JEPAltam/FFF-3DPrinter-CoreXY-Duet-LoadCell/media/photos/assembly/electronic_integration.jpg

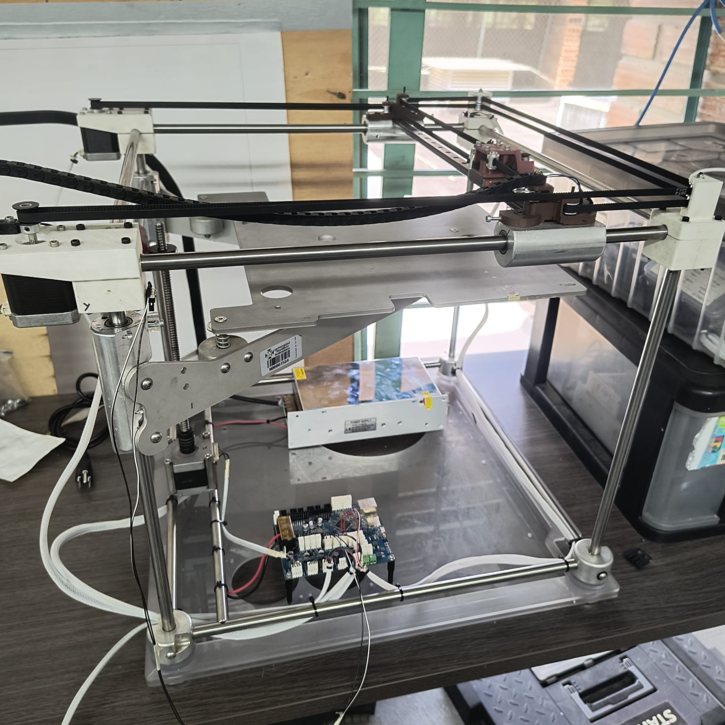
media/photos/assembly/electronic_integration.jpg
