JEPAltam/FFF-3DPrinter-CoreXY-Duet-LoadCell/media/photos/finished_machine/Complete_system_integration2.jpg

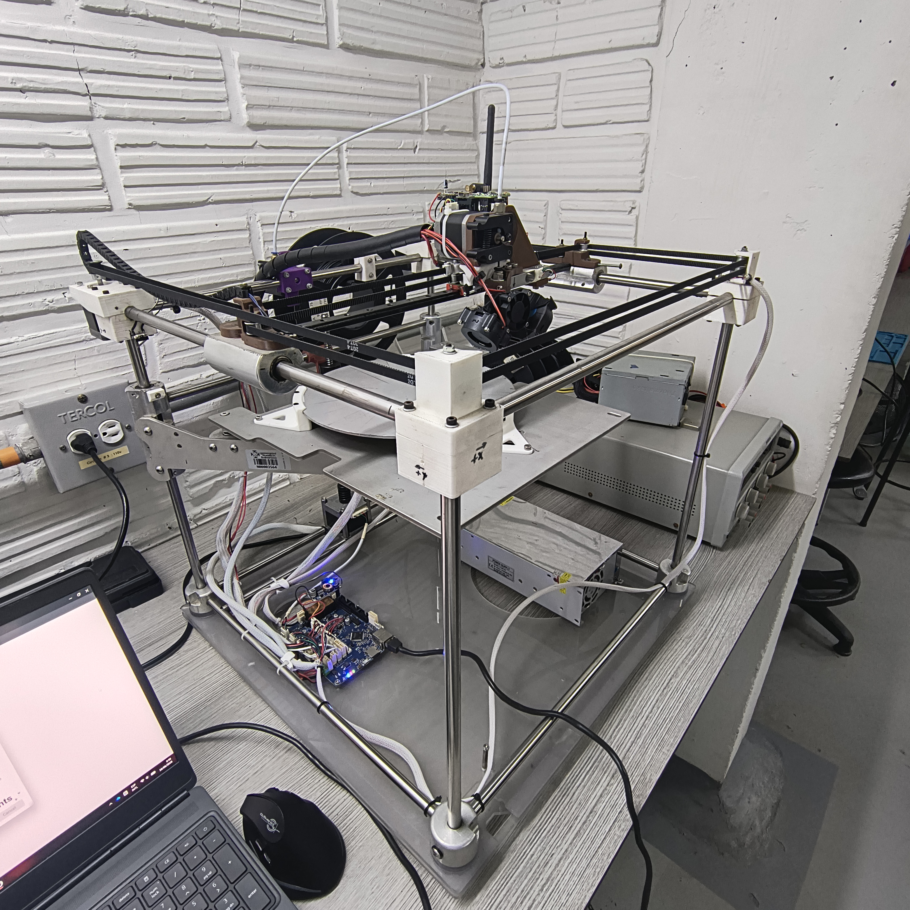
media/photos/finished_machine/Complete_system_integration2.jpg
