JEPAltam/FFF-3DPrinter-CoreXY-Duet-LoadCell/mechanical/bom/BOM.xlsx

Sheet: 1 - Mechanical BOM
Bill of Materials — Structural & Mechanical Components
Designator | Component | No. | Cost/unit (USD) | Total cost (USD) | Source of materials | Material type
STRUCTURAL FRAME
Structural_frame1/2; Z_Motor_mount1/2 and Z-smooth_rod | Stainless steel rod 12 mm × 500 mm. Reused legacy printer | 13 | 23.11 | 300.43 | https://es.aliexpress.com/item/1005009384686024.html | Metal
Corner_bracket_L/R/FL/FR | Printed corner bracket, PLA, 133 g | 4 | 1 | 4 | In-house FFF, UPB workshop | Polymer
Motor_mount_bracket_L/R | Printed motor mount, PLA, 121 g | 2 | 1.81 | 3.62 | In-house FFF, UPB workshop | Polymer
Pulley_mount_bracket_L/R | Printed pulley housing, PLA, 50 g | 2 | 0.75 | 1.5 | In-house FFF, UPB workshop | Polymer
Pulley_support_L/R | Printed pulley support, PLA, 29 g | 2 | 0.5 | 1 | In-house FFF, UPB workshop | Polymer
Nema 17 | NEMA 17 stepper motor, 0.6 N·m | 3 | 12.86 | 38.58 | https://es.aliexpress.com/item/1005010127780067.html | Metal
MGN12_rail | MGN12 linear guide rail, 400 mm | 1 | 18 | 18 | https://es.aliexpress.com/item/1005007149925240.html | Metal
Belt_lower/upper | GT2 timing belt, 6 mm wide, per metre | 2 | 4 | 8 | https://es.aliexpress.com/item/1005010670220355.html | Polymer
2GT_pulley20T | GT2 20-tooth drive pulley, 5 mm bore | 2 | 4.66 | 9.32 | https://es.aliexpress.com/item/1005012119340007.html | Metal
2GT_idler_16T | GT2 16-tooth idler pulley with bearing | 4 | 2 | 8 | https://es.aliexpress.com/item/1005004893007344.html | Metal
Microswitch | Endstop microswitch, SPDT, 1 A | 3 | 0.8 | 2.4 | https://es.aliexpress.com/item/1005009049556408.html | Semiconductor
Z-AXIS
Z-mount and Z-Endswitch_trigger | Printed Z-axis bracket, PLA, 11 g | 1 | 0.31 | 0.31 | In-house FFF, UPB workshop | Polymer
Z-axis_lead_screw | Reused legacy printer. Can be printed | 1 | 0.3 | 0.3 | In-house FFF, UPB workshop | Polymer
Trapezoidal_lead_screw_10mm | Trapezoidal lead screw T10, 2 mm pitch, 300 mm + nut | 1 | 10.23 | 10.23 | https://es.aliexpress.com/item/4000909583486.html | Metal
Flexible_coupling_6mm | D15 L22 6-6 mm. Connection to trapezoidal lead screw | 1 | 5 | 5 | https://es.aliexpress.com/item/1005005551683727.html | Metal
Linear_slide_bush_L/R and Z-sliding_bushing_L/R | Custom linear bushing, machined. Reused legacy printer | 4 | - | - | In-house UPB milling machine | Metal
Ball_sleeve_KH1228 | KH1228. Reused legacy printer | 4 | 15.6 | 62.4 | https://es.aliexpress.com/w/wholesale-KH1228.html | Metal
Nema 23 | NEMA 23 stepper motor, 1.3 N·m | 1 | 31 | 31 | https://es.aliexpress.com/item/1005004803177431.html | Metal
PRINT BED
Heat_bed | Heated bed, 200 mm dia., 24 V, 120 W. Reused Kossel delta. | 1 | 22 | 22 | https://es.aliexpress.com/item/1005010009605532.html | Metal
Bed_support | Machined. Reused legacy printer. | 1 | - | - | In-house, UPB workshop | Metal
Heat_bed_mount | Machined. Reused legacy printer. | 2 | - | - | In-house, UPB workshop | Metal
Heat_bed_support and Heat_bed_mount_support | Machined. Reused legacy printer. | 3 | - | - | In-house, UPB workshop | Metal
Centring_bracket and Clamp_centring_bracket | Printed centering bed, PLA, 73 g | 6 | 0.37 | 2.22 | In-house FFF, UPB workshop | Polymer
Leveling_feet and Leveling_feet_screw | Machined. Reused legacy printer. | 8 | - | - | In-house UPB workshop | Metal
Bed_feet | Reused legacy printer. | 1 | - | - | In-house UPB | Polymer
EXTRUDER AND HOTEND
E3DV5 | 3DV5 hotend assembly, 0.4 mm nozzle, 24 V | 1 | 20 | 20 | Reused from Anycubic Kossel Plus Delta | Metal
Extruder_body; Extruder_mount and X-Endswitch_trigger | Printed extruder body, PLA, 43.5 g | 3 | 1.3 | 3.9 | In-house FFF, UPB workshop | Polymer
4020TB | 40×20 mm radial blower fan, 12 V, 0.1 A | 2 | 3.14 | 6.28 | https://es.aliexpress.com/item/1005005517858332.html | Polymer
Fan_support | Printed part-cooling 4020 blower fan support, PLA, 7 g | 1 | 0.21 | 0.21 | In-house FFF, UPB workshop | Polymer
Duct_radial | Printed cooling fan heat skin, PLA, 7 g | 1 | 0.21 | 0.21 | In-house FFF, UPB workshop | Polymer
Duct_Blower1/2 | Printed duct layer fan, PLA, 5 g | 1 | 0.14 | 0.14 | In-house FFF, UPB workshop | Polymer
Fan4010 | 40×10 mm radial heat skin fan, 12 V, 0.1 A | 1 | 13 | 13 | https://es.aliexpress.com/item/1005006306536871.html | Polymer
Bowden_tube | PTFE tube, 2 mm ID / 4 mm OD, per metre | 1 | 13 | 13 | https://es.aliexpress.com/item/1005003579739761.html | Polymer
Extruder_MK8 | Kit idler pivot loaded system | 1 | 16.5 | 16.5 | https://es.aliexpress.com/item/1005003217904544.html | Metal
FORCE SENSING MODULE
Load_cell_75mm | Bending-beam load cell, 75 mm, 1 kg, ±0.05% FS | 1 | 14 | 14 | https://es.aliexpress.com/item/1005012383607240.html | Metal
HX711 | HX711 24-bit ADC amplifier board | 1 | 5 | 5 | https://es.aliexpress.com/item/1005012383607240.html | Semiconductor
Load_cell_mount; Load_cell_heatsink_support and Load_cell_heatsink_fastening | Printed load cell mounting bracket, PLA, 20 g | 3 | 0.7 | 2.1 | In-house FFF, UPB workshop | Polymer
Sensors_support_arm and Sensors_support | Printed sensor support, PLA, 18 g | 2 | 0.54 | 1.08 | In-house FFF, UPB workshop | Polymer
SUBTOTAL — Mechanical & Structural (USD) |  |  |  | 623.73

Sheet: 2 - Electronics BOM
Bill of Materials — Electronics & Cable Management
Designator | Component | No. | Cost/unit (USD) | Total cost (USD) | Source of materials | Material type
ELECTRONICS AND CONTROL
Duet3D_board | Duet Maestro 2, RepRapFirmware | 1 | 54 | 54 | https://es.aliexpress.com/item/1005005037824542.html | Semiconductor
Arduinonano | Arduino Nano V3.0 Mini CH340 | 2 | 15 | 30 | https://es.aliexpress.com/item/1005008982247575.html | Semiconductor
NRF24L01 | NRF24L01 + antenna | 2 | 4 | 8 | https://es.aliexpress.com/item/1005006975747743.html | Semiconductor
Power_supply | MeanWell LRS-350-24, 24 V / 14.6 A | 1 | 64 | 64 | https://es.aliexpress.com/item/1005009359704155.html | Metal
DC-DC_3A | DC-DC buck converter, 24 V to 5 V, 3 A | 1 | 4 | 4 | https://es.aliexpress.com/item/1005012415089723.html | Semiconductor
L15841 | DC-DC MP1584EN 3 A 3.3/5/9/12 V | 1 | 4 | 4 | https://es.aliexpress.com/item/1005012144215392.html | Semiconductor
CABLE MANAGEMENT
Energy_chain | Cable drag chain, 10 mm, 500 mm | 1 | 20 | 20 | https://es.aliexpress.com/w/wholesale-Cable-drag-chain-10mm.html | Polymer
Wire_clip | Printed wire routing clip, PLA, 19.5 g | 10 | 0.1 | 1 | In-house FFF, UPB workshop | Polymer
Wiring_harness | Shielded cables, connectors, ferrules | 1 | 20 | 20 | Local store | Wiring
Power_supply_anchors | Sheet metal part | 4 | - | - | In-house UPB workshop | Metal
Duet3D_board_separator | Printed spacer. Can be printed in PLA. | 5 | - | - | In-house FFF, UPB workshop | Polymer
SUBTOTAL — Electronics (USD) |  |  |  | 205.00

Sheet: 3 - Fasteners & Supplies
Bill of Materials — Fasteners & Consumable Supplies
Designator | Component | No. | Cost/unit (USD) | Total cost (USD) | Source of materials | Material type
FASTENERS
M3x5_screw | Socket head cap screw M3×5, DIN 913 | 10 | 0.04 | 0.4 | Local store | Metal
M3x6_screw | Socket head cap screw M3×6, DIN 912 | 2 | 0.05 | 0.1 | Local store | Metal
M3x8_set_screw | Set screw M3×8, DIN 912 | 4 | 0.05 | 0.2 | Local store | Metal
M3x12_screw | Socket head cap screw M3×12, DIN 912 | 25 | 0.05 | 1.25 | Local store | Metal
M3x16_screw | Socket head cap screw M3×16, DIN 912 | 16 | 0.05 | 0.8 | Local store | Metal
M3x20_screw | Socket head cap screw M3×20, DIN 912 | 20 | 0.06 | 1.2 | Local store | Metal
M3x25_screw | Socket head cap screw M3×25, DIN 912 | 18 | 0.06 | 1.08 | Local store | Metal
M3x30_screw | Socket head cap screw M3×30, DIN 912 | 10 | 0.07 | 0.7 | Local store | Metal
M3x40_screw | Socket head cap screw M3×40, DIN 912 | 8 | 0.08 | 0.64 | Local store | Metal
M3x50_screw | Socket head cap screw M3×50, DIN 912 | 6 | 0.09 | 0.54 | Local store | Metal
M4x10_screw | Socket head cap screw M4×10, DIN 912 | 8 | 0.06 | 0.48 | Local store | Metal
M4x40_countersunk_screw | Socket countersunk screw M4×40 | 3 | 0.06 | 0.18 | Local store | Metal
M5x8_screw | Socket head cap screw M5×8, DIN 912 | 8 | 0.07 | 0.56 | Local store | Metal
M5x12_screw | Round head screw M5×12 | 20 | 0.07 | 1.4 | Local store | Metal
M5x60_screw | Socket head cap screw M5×60, DIN 912 | 4 | 0.09 | 0.36 | Local store | Metal
M1.6x10_screw | Microswitch fixing screw M1.6×10 | 6 | 0.05 | 0.3 | Local store | Metal
M3_nut | Hex nut M3, DIN 934 | 30 | 0.03 | 0.9 | Local store | Metal
M4_nut | Hex nut M4, DIN 934 | 2 | 0.03 | 0.09 | Local store | Metal
M4_Locknut | Hex lock nut M4 | 3 | 0.03 | 0.09 | Local store | Metal
M3_washer | Flat washer M3, DIN 125 | 30 | 0.02 | 0.6 | Local store | Metal
CONSUMABLE SUPPLIES
PLA | Filament PLA, 1 Kg, 1.75 mm | 1 | 62.35 | 62.35 | https://es.aliexpress.com/item/1005005828203221.html | Polymer
Cable sleeve | Cable sleeve 25 mm × 3 m | 1 | 14.5 | 14.5 | https://es.aliexpress.com/item/1005011969040670.html | Polymer
Heat-shrinkable sleeve | Heat-shrinkable sleeve, 127 pieces set | 1 | 14 | 14 | https://es.aliexpress.com/item/1005008146302901.html | Polymer
Plastic clamps | Plastic clamps 2.5 mm × 150 mm, 200 pieces | 1 | 15 | 15 | https://es.aliexpress.com/item/1005008455611389.html | Polymer
Hot-melt adhesive | Hot-melt adhesive 11 mm × 150 mm, 10 pieces | 1 | 18 | 18 | https://es.aliexpress.com/item/4000748720733.html | Polymer
SUBTOTAL — Fasteners & Supplies (USD) |  |  |  | 135.72

Sheet: 4 - Grand Total Summary
Bill of Materials — Grand Total Summary
Category | Subtotal (USD) | Notes
Structural & Mechanical Components | $623.73 | Tables 5 (paper)
Electronics & Cable Management | $205.00 | Table 6 (paper)
Fasteners & Consumable Supplies | $135.72 | Table 7 (paper)
GRAND TOTAL | $964.45 | Total estimated cost (USD)
Note: Cells marked '-' are reused or machined in-house with no direct material cost. Corrected totals applied: Extruder_body (3×$1.30=$3.90), Load_cell_mount (3×$0.70=$2.10), Sensors_support_arm (2×$0.54=$1.08).
