JEPAltam/FFF-3DPrinter-CoreXY-Duet-LoadCell/(list of files, cad)

Other CAD files:
mechanical/CAD/1.1_Parts/1.1.3_Electronic/Power_supply_anchors.psm
mechanical/CAD/1.1_Parts/1.1.7_Extruder/Spool_holder.psm
