JEPAltam/FFF-3DPrinter-CoreXY-Duet-LoadCell/mechanical/drawings/Assembly_Bill_materials.pdf

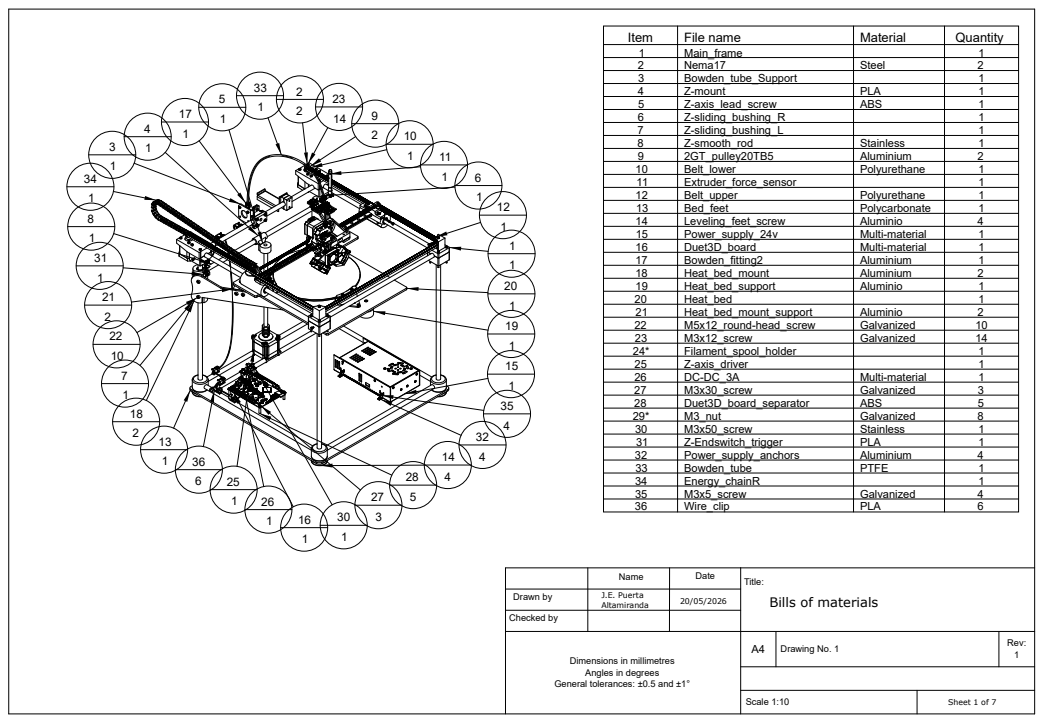
[picture p7: page 1]
Item; File name; Material; Quantity 1; Main_frame; Nema17; Steel; Bowden_tube_Support; Z-mount; PLA; Z-axis_lead_screw; ABS; Z-sliding_bushing_R; Z-sliding_bushing_L; Z-smooth_rod; Stainless; 2GT_pulley20TB5; Aluminium; Belt_lower; Polyurethane; Extruder_force_sensor; Belt_upper; Bed_feet; Polycarbonate; Leveling_feet_screw; Aluminio; Power_supply_24v; Multi-material; Duet3D_board; Bowden_fitting2; Heat_bed_mount; Heat_bed_support; Heat_bed; Heat_bed_mount_support; M5x12_round-head_screw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

Bills of materials

Dimensions in millimetres
Angles in degrees
General tolerances: ±0.5 and ±1°

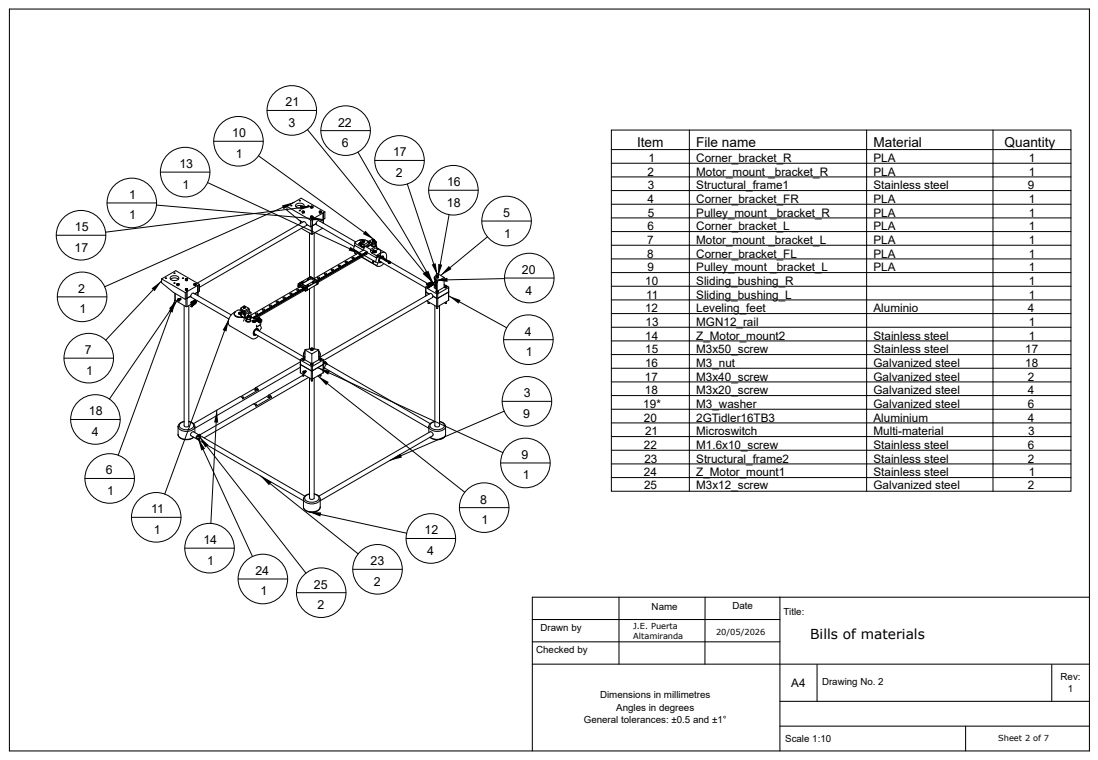
[picture p8: page 2]
Item; File name; Material; Quantity 1; Corner_bracket_R; PLA; Motor_mount _bracket_R; Structural_frame1; Stainless steel; Corner_bracket_FR; Pulley_mount _bracket_R; Corner_bracket_L; Motor_mount _bracket_L; Corner_bracket_FL; Pulley_mount _bracket_L; Sliding_bushing_R; Sliding_bushing_L; Leveling_feet; Aluminio; MGN12_rail; Z_Motor_mount2; M3x50_screw; M3_nut; Galvanized steel; M3x40_screw; M3x20_screw; M3_washer; 2GTidler16TB3; Aluminium; Microswitch; Multi-material; M1.6x10_screw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

Name | Date | Title: Bills of materials

Drawn by | J.E. Puerta Altamiranda | 20/05/2026

Checked by

Dimensions in millimetres Angles in degrees General tolerances: ±0.5 and ±1° | A4 | Drawing No. 2 | Rev: 1

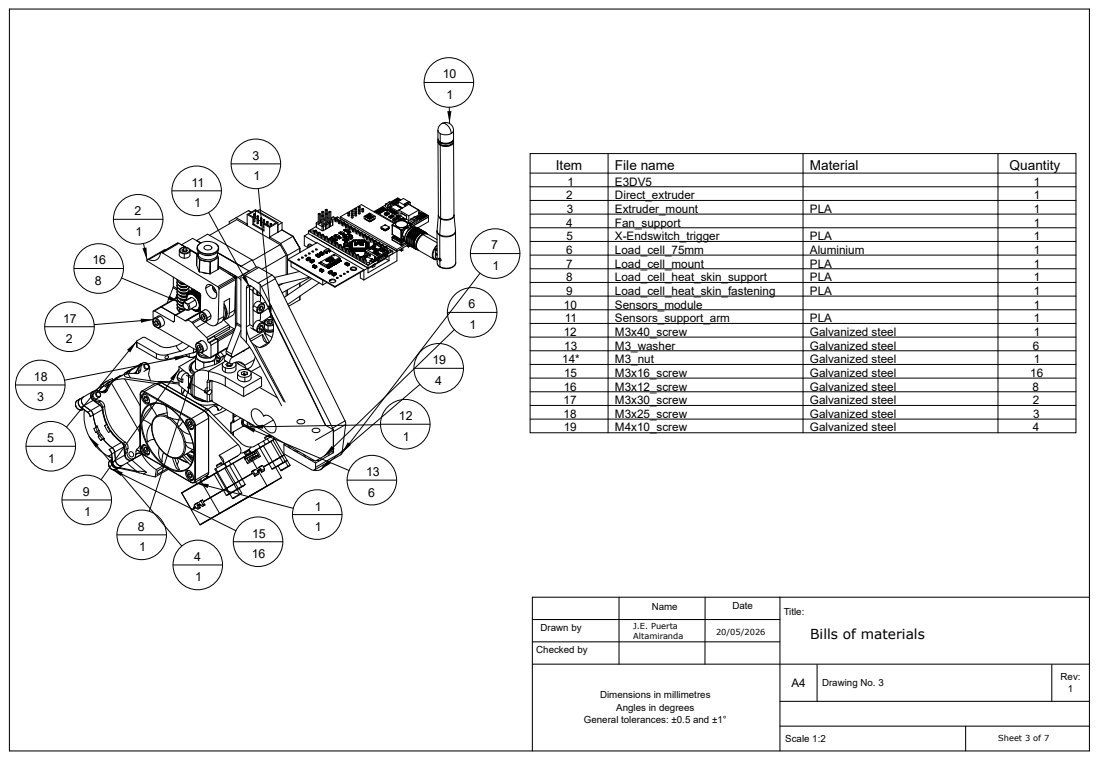
[picture p9: page 3]
Item; File name; Material; Quantity 1; Direct_extruder; Extruder_mount; PLA; Fan_support; X-Endswitch_trigger; Load_cell_75mm; Aluminium; Load_cell_mount; Load_cell_heat_skin_support; Load_cell_heat_skin_fastening; Sensors_module; Sensors_support_arm; M3x40_screw; Galvanized steel; M3_washer; M3_nut; M3x16_screw; M3x12_screw; M3x30_screw; M3x25_screw; M4x10_screw; Drawn by; Checked by; Name; Date; Title:; Drawing No. 3; Rev: 1; J.E. Puerta; Altamiranda

Bills of materials

Dimensions in millimetres
Angles in degrees
General tolerances: ±0.5 and ±1°

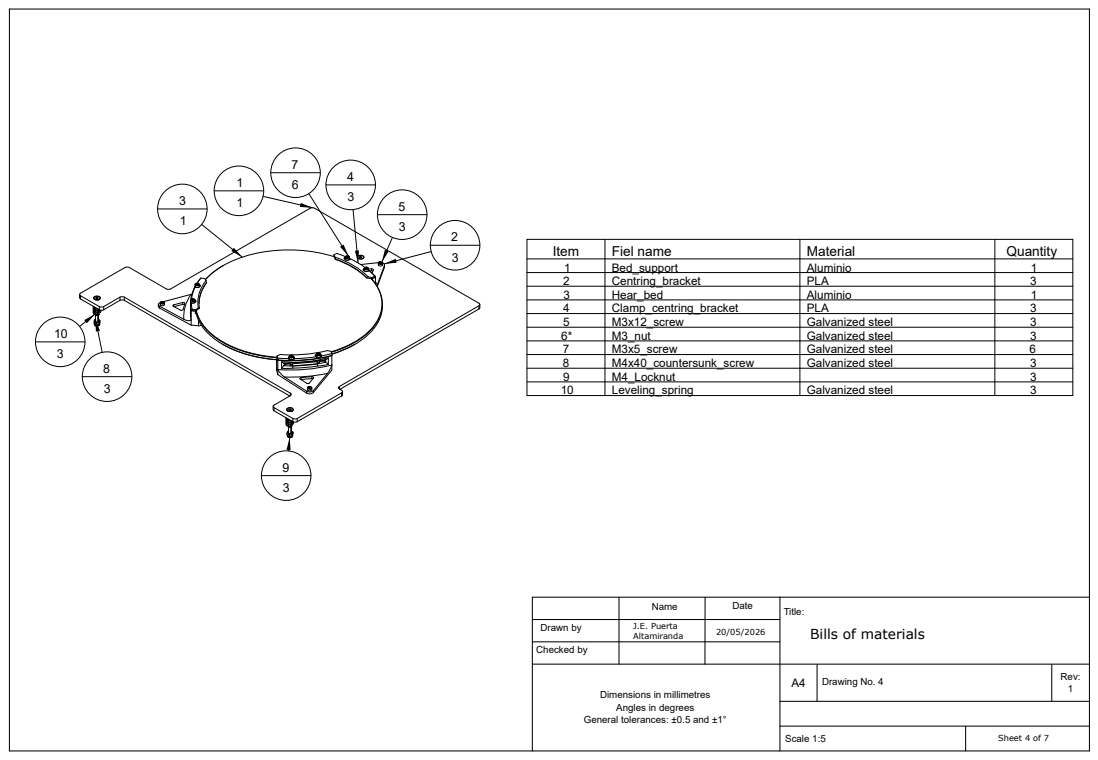
[picture p10: page 4]
Item; Fiel name; Material; Quantity 1; Bed_support; Aluminio; Centring_bracket; PLA; Hear_bed; Clamp_centring_bracket; M3x12_screw; Galvanized steel; M3_nut; M3x5_screw; M4x40_countersunk_screw; M4_Locknut; Leveling_spring

Name | Date | Title: Bills of materials

Drawn by | J.E. Puerta Altamiranda | 20/05/2026

Checked by

Dimensions in millimetres Angles in degrees General tolerances: ±0.5 and ±1° | A4 | Drawing No. 4 | Rev: 1

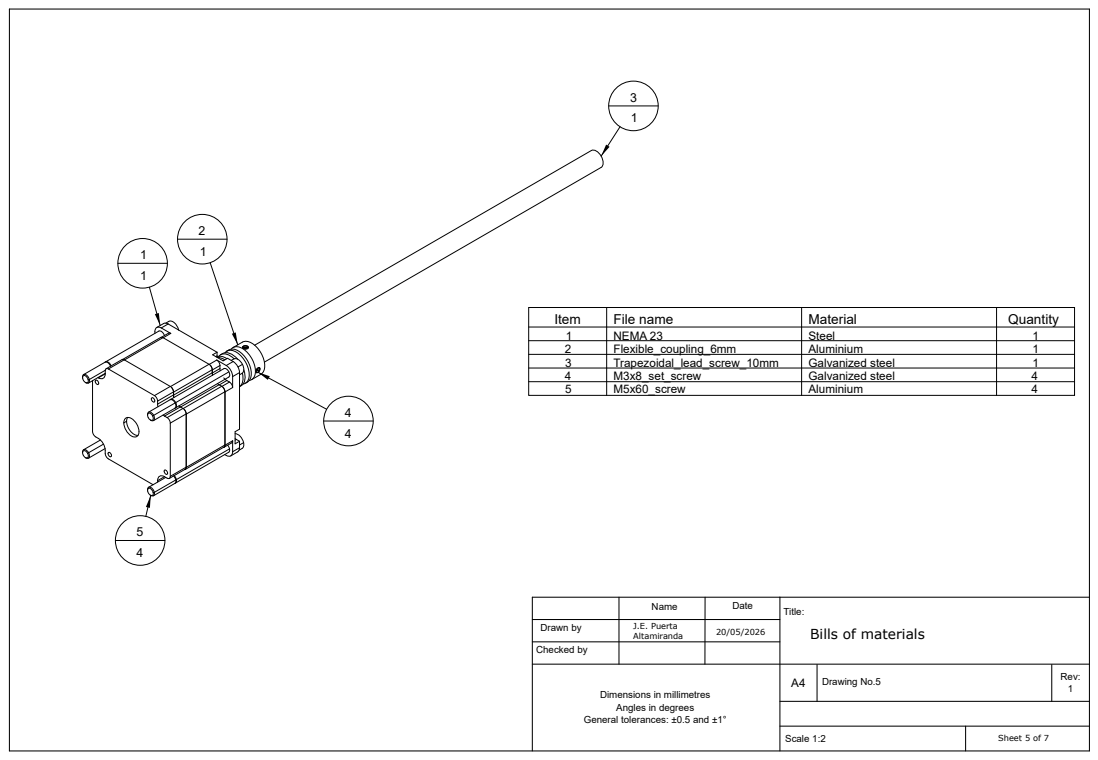
[picture p11: page 5]
Item; File name; Material; Quantity; NEMA 23; Steel; Flexible_coupling_6mm; Aluminium; Trapezoidal_lead_screw_10mm; Galvanized steel; M3x8_set_screw; M5x60_screw

Name | Date | Title: Bills of materials

Drawn by | J.E. Puerta Altamiranda | 20/05/2026

Checked by

Dimensions in millimetres Angles in degrees General tolerances: ±0.5 and ±1° | A4 | Drawing No.5 | Rev: 1

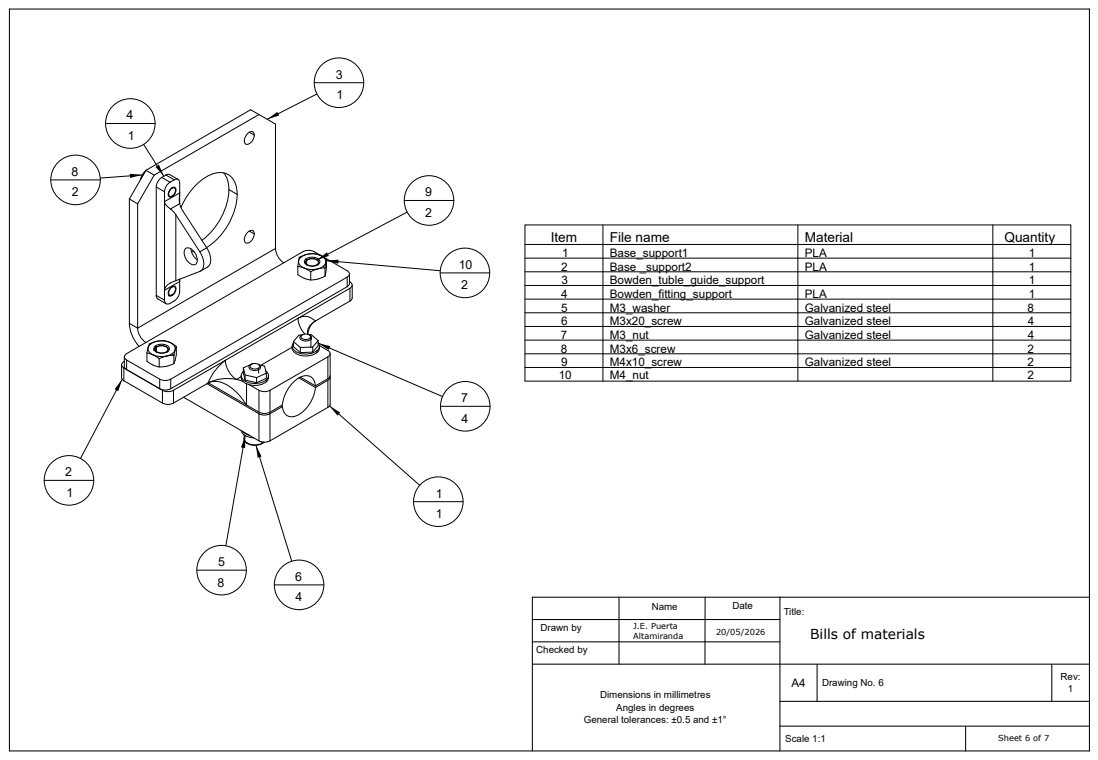
[picture p12: page 6]
Item; File name; Material; Quantity 1; Base_support1; PLA; Base _support2; Bowden_tuble_guide_support; Bowden_fitting_support; M3_washer; Galvanized steel; M3x20_screw; M3_nut; M3x6_screw; M4x10_screw; M4_nut

Name | Date | Title: Bills of materials

Drawn by | J.E. Puerta Altamiranda | 20/05/2026

Checked by

Dimensions in millimetres Angles in degrees General tolerances: ±0.5 and ±1° | A4 | Drawing No. 6 | Rev: 1

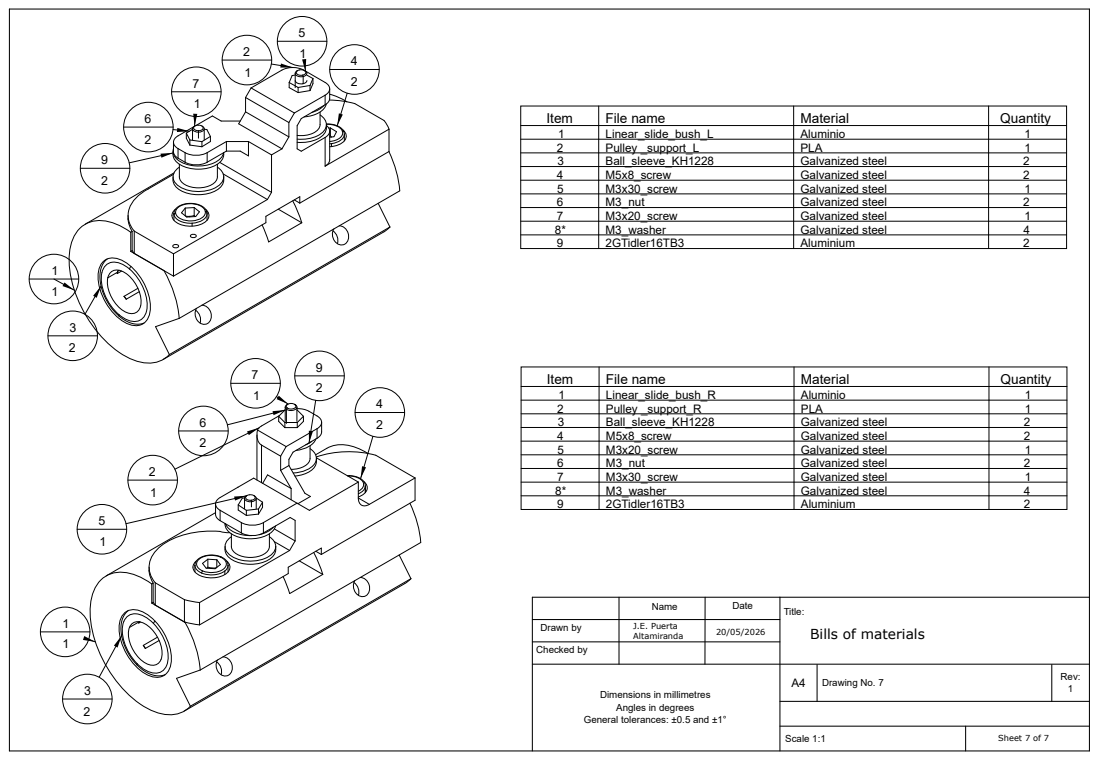
[picture p13: page 7]
Item; File name; Material; Quantity 1; Linear_slide_bush_L; Aluminio; Pulley _support_L; PLA; Ball_sleeve_KH1228; Galvanized steel; M5x8_screw; M3x30_screw; M3_nut; M3x20_screw; M3_washer; 2GTidler16TB3; Aluminium; Linear_slide_bush_R; Pulley _support_R

Name | Date | Title: Bills of materials

Drawn by | J.E. Puerta Altamiranda | 20/05/2026

Checked by

Dimensions in millimetres Angles in degrees General tolerances: ±0.5 and ±1° | A4 | Drawing No. 7 | Rev: 1
