JEPAltam/FFF-3DPrinter-CoreXY-Duet-LoadCell/mechanical/drawings/Assembly_drawing.pdf

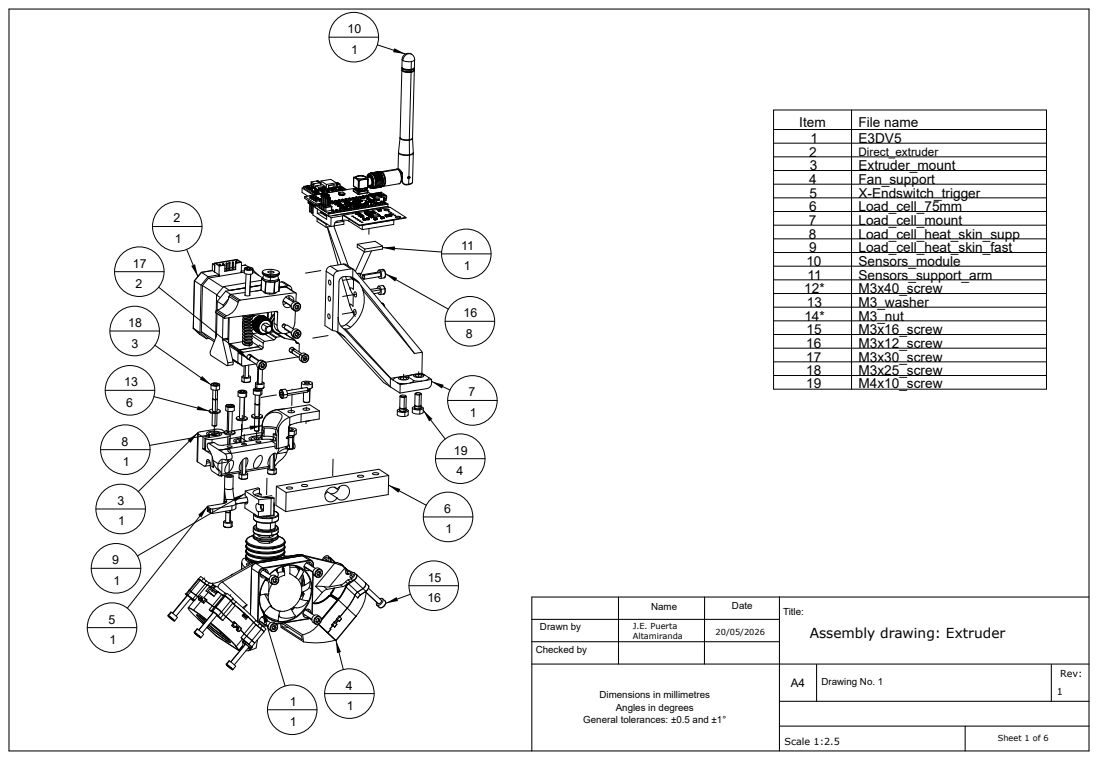
[picture p14: page 1]
Item; File name 1; Direct_extruder 3; Extruder_mount 4; Fan_support 5; X-Endswitch_trigger 6; Load_cell_75mm 7; Load_cell_mount 8; Load_cell_heat_skin_supp 9; Load_cell_heat_skin_fast; Sensors_module; Sensors_support_arm; M3x40_screw; M3_washer; M3_nut; M3x16_screw; M3x12_screw; M3x30_screw; M3x25_screw; M4x10_screw; Drawn by; Checked by; Name; Date; Title:; Drawing No. 1; J.E. Puerta; Altamiranda; Sheet 1 of 6; Rev: 1; Scale 1:2.5

Assembly drawing: Extruder

Dimensions in millimetres
Angles in degrees
General tolerances: ±0.5 and ±1°

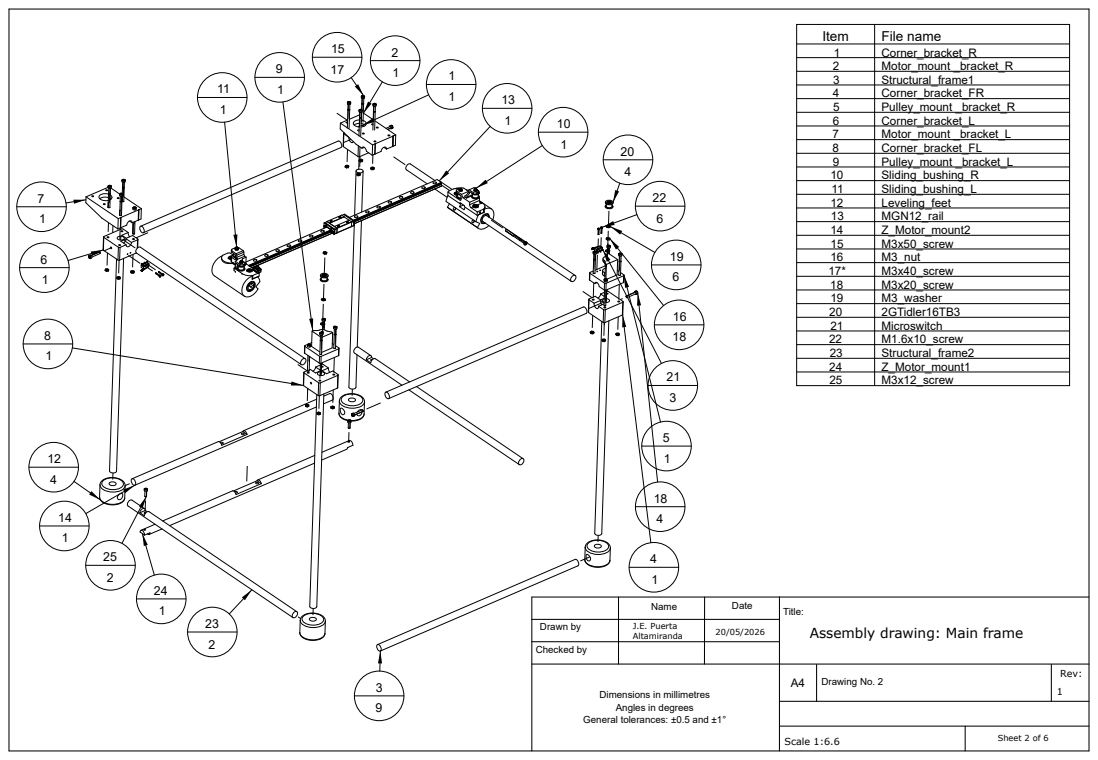
[picture p15: page 2]
Item; File name 1; Corner_bracket_R 2; Motor_mount _bracket_R 3; Structural_frame1 4; Corner_bracket_FR 5; Pulley_mount _bracket_R 6; Corner_bracket_L 7; Motor_mount _bracket_L 8; Corner_bracket_FL 9; Pulley_mount _bracket_L; Sliding_bushing_R; Sliding_bushing_L; Leveling_feet; MGN12_rail; Z_Motor_mount2; M3x50_screw; M3_nut; M3x40_screw; M3x20_screw; M3_washer; 2GTidler16TB3; Microswitch; M1.6x10_screw; Structural_frame2; Z_Motor_mount1; M3x12_screw; Scale 1:6.6

Name | Date | Title: Assembly drawing: Main frame

Drawn by | J.E. Puerta Altamiranda | 20/05/2026

Checked by

Dimensions in millimetres Angles in degrees General tolerances: ±0.5 and ±1° | A4 | Drawing No. 2 | Rev: 1

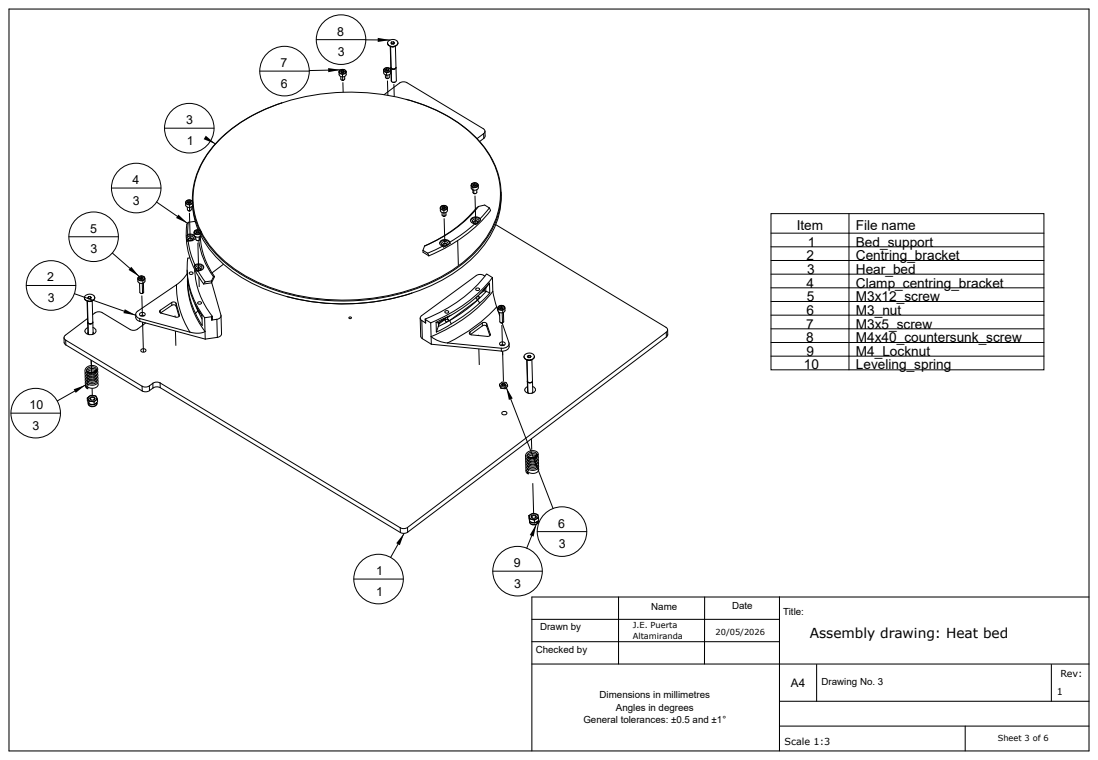
[picture p16: page 3]
Item; File name; Bed_support; Centring_bracket; Hear_bed; Clamp_centring_bracket; M3x12_screw; M3_nut; M3x5_screw; M4x40_countersunk_screw; M4_Locknut; Leveling_spring; Scale 1:3

Name | Date | Title: Assembly drawing: Heat bed

Drawn by | J.E. Puerta Altamiranda | 20/05/2026

Checked by

Dimensions in millimetres Angles in degrees General tolerances: ±0.5 and ±1° | A4 | Drawing No. 3 | Rev: 1

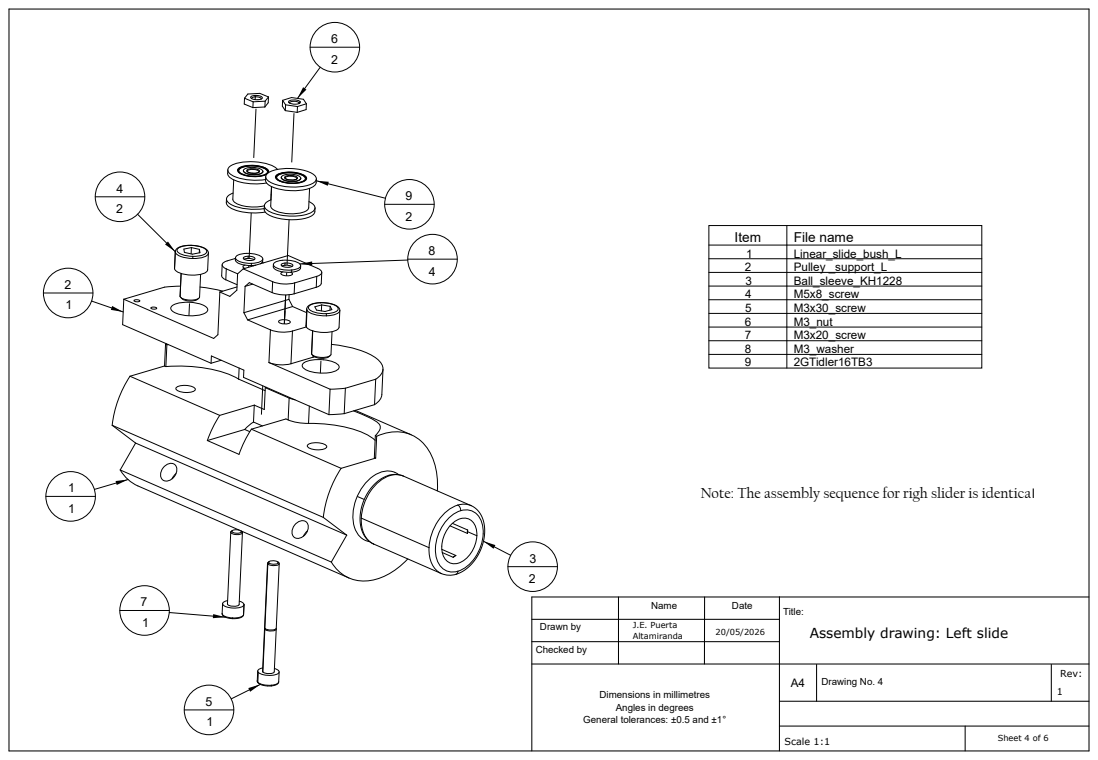
[picture p17: page 4]
Item; File name; Linear_slide_bush_L; Pulley _support_L; Ball_sleeve_KH1228; M5x8_screw; M3x30_screw; M3_nut; M3x20_screw; M3_washer; 2GTidler16TB3

Note: The assembly sequence for righ slider is identical

Name | Date | Title: Assembly drawing: Left slide

Drawn by | J.E. Puerta Altamiranda | 20/05/2026

Checked by

Dimensions in millimetres Angles in degrees General tolerances: ±0.5 and ±1° | A4 | Drawing No. 4 | Rev: 1

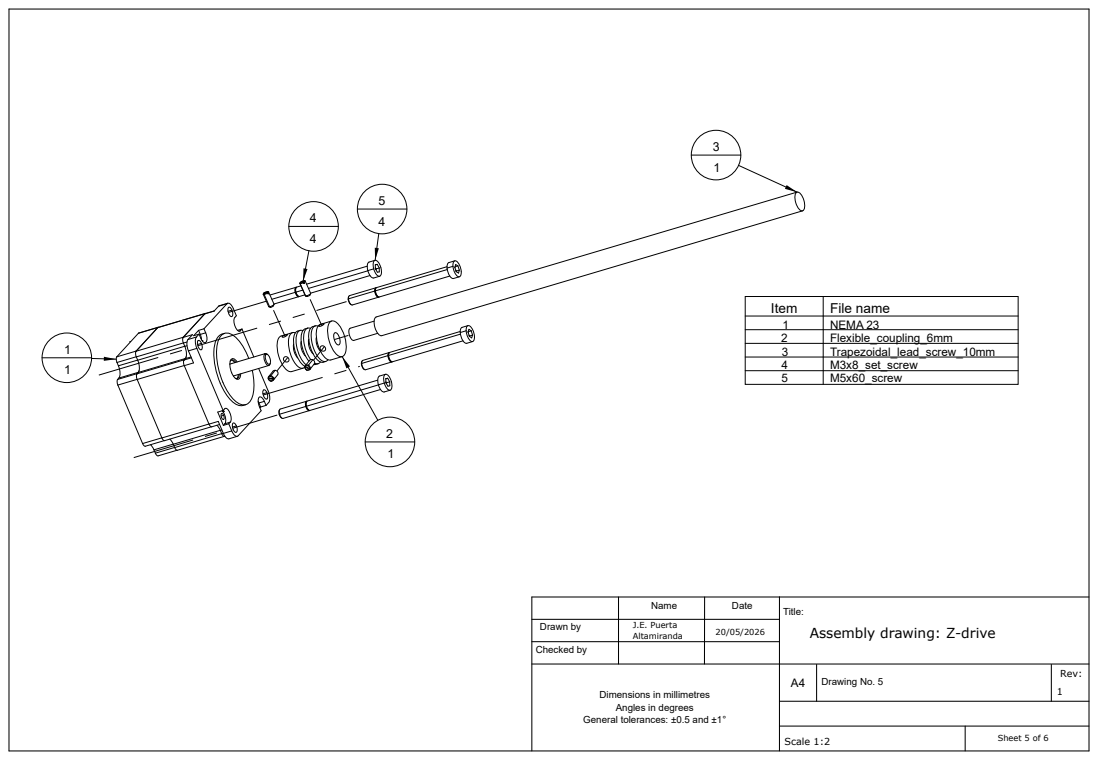
[picture p18: page 5]
Item; File name; NEMA 23; Flexible_coupling_6mm; Trapezoidal_lead_screw_10mm; M3x8_set_screw; M5x60_screw

Name | Date | Title: Assembly drawing: Z-drive

Drawn by | J.E. Puerta Altamiranda | 20/05/2026

Checked by

Dimensions in millimetres Angles in degrees General tolerances: ±0.5 and ±1° | A4 | Drawing No. 5 | Rev: 1

C

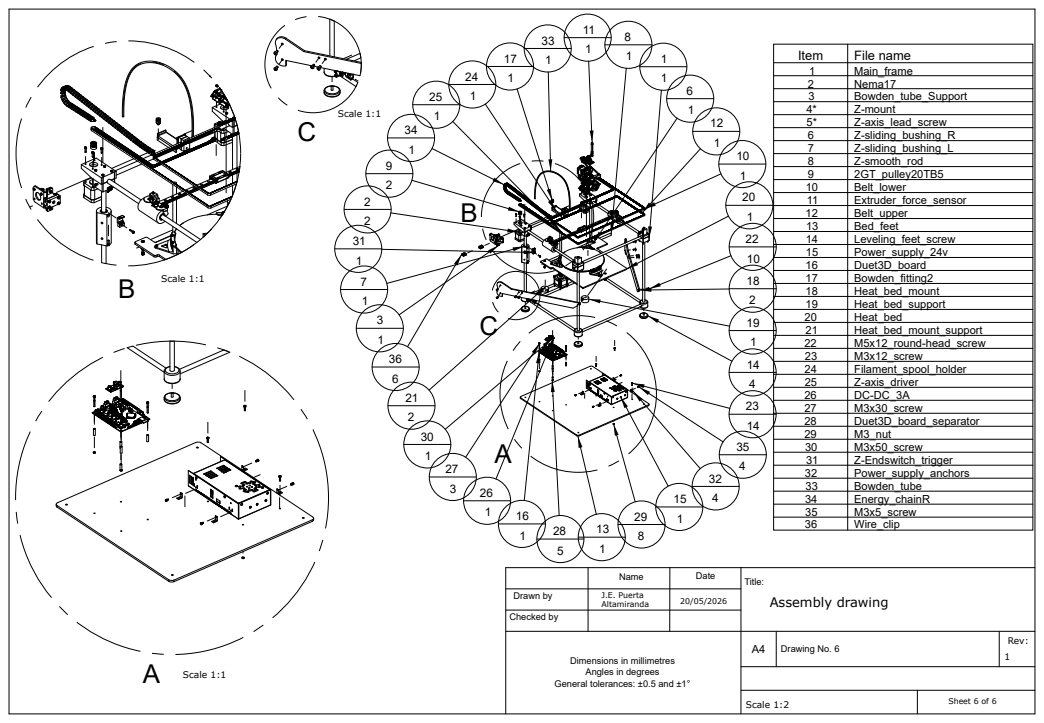
[picture p19: page 6]
Item; File name; Main_frame; Nema17; Bowden_tube_Support; Z-mount; Z-axis_lead_screw; Z-sliding_bushing_R; Z-sliding_bushing_L; Z-smooth_rod; 2GT_pulley20TB5; Belt_lower; Extruder_force_sensor; Belt_upper; Bed_feet; Leveling_feet_screw; Power_supply_24v; Duet3D_board; Bowden_fitting2; Heat_bed_mount; Heat_bed_support; Heat_bed; Heat_bed_mount_support; M5x12_round-head_screw; M3x12_screw; Filament_spool_holder; Z-axis_driver; M3x30_screw; Duet3D_board_separator; M3_nut; M3x50_screw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

Dimensions in millimetres
Angles in degrees
General tolerances: ±0.5 and ±1°
