JEPAltam/FFF-3DPrinter-CoreXY-Duet-LoadCell/mechanical/CAD/1.2_Assemblys/1.2.1_ASM/Reactivation_Upgrading_FFF_3D_Printer_CoreXY_2.pdf

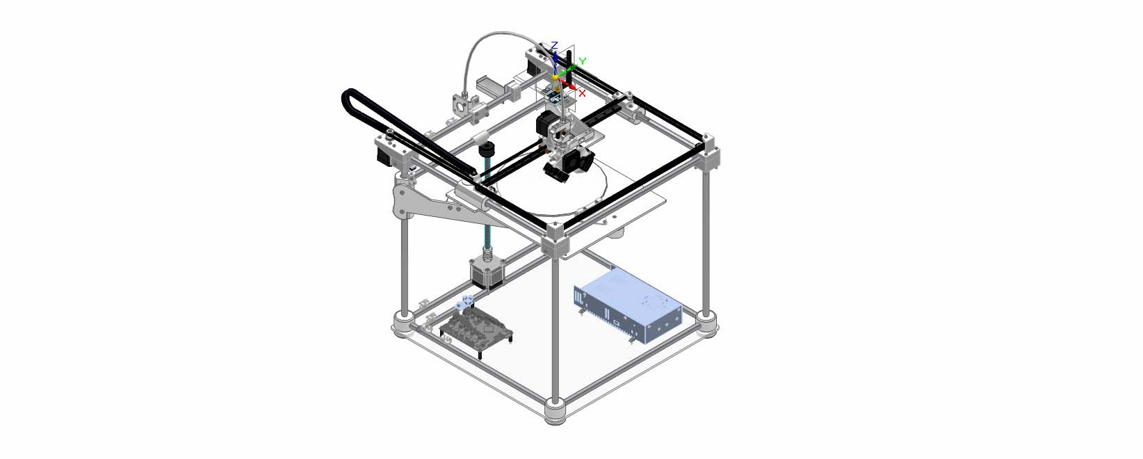
[picture p20: figure]
