JEPAltam/FFF-3DPrinter-CoreXY-Duet-LoadCell/media/photos/assembly/corner_bracket_1.jpg

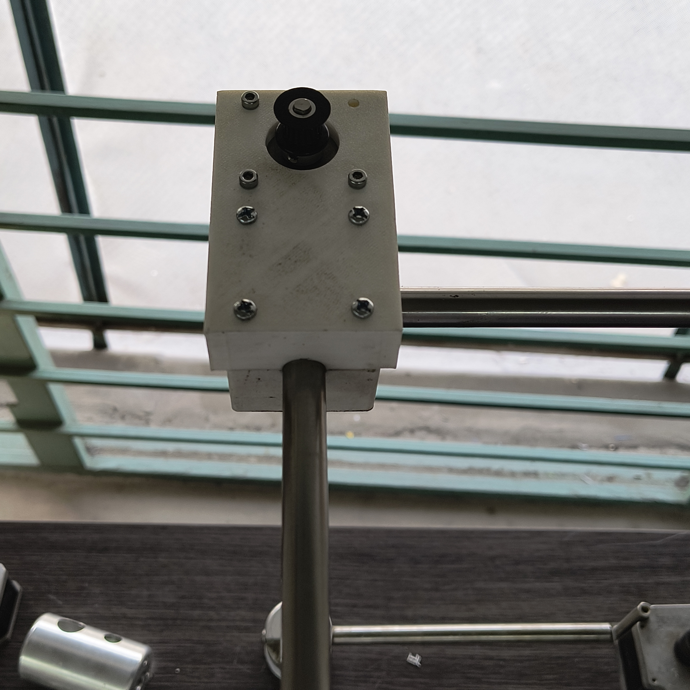
media/photos/assembly/corner_bracket_1.jpg
