JEPAltam/FFF-3DPrinter-CoreXY-Duet-LoadCell/media/photos/assembly/corner_bracket_2.jpg

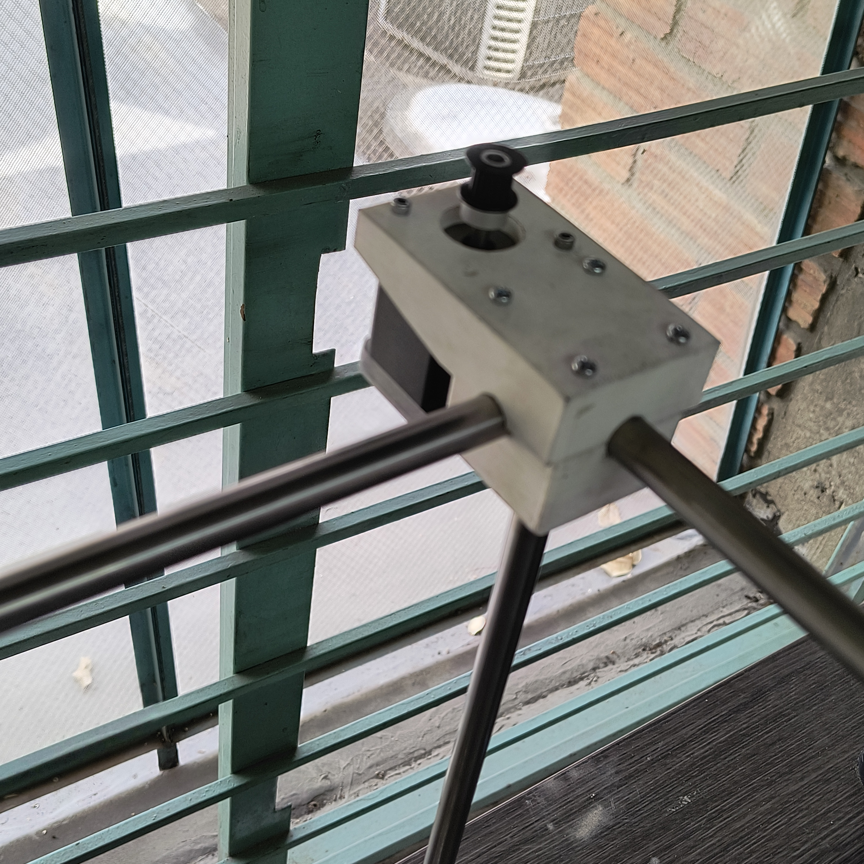
media/photos/assembly/corner_bracket_2.jpg
