JEPAltam/FFF-3DPrinter-CoreXY-Duet-LoadCell/media/photos/assembly/electric_conection.jpg

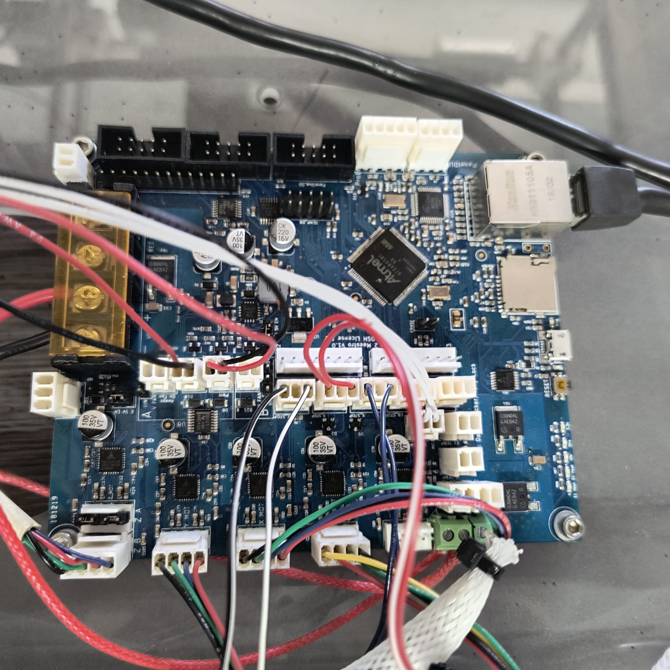
media/photos/assembly/electric_conection.jpg
