JEPAltam/FFF-3DPrinter-CoreXY-Duet-LoadCell/media/photos/assembly/linear_slide_bush.jpg

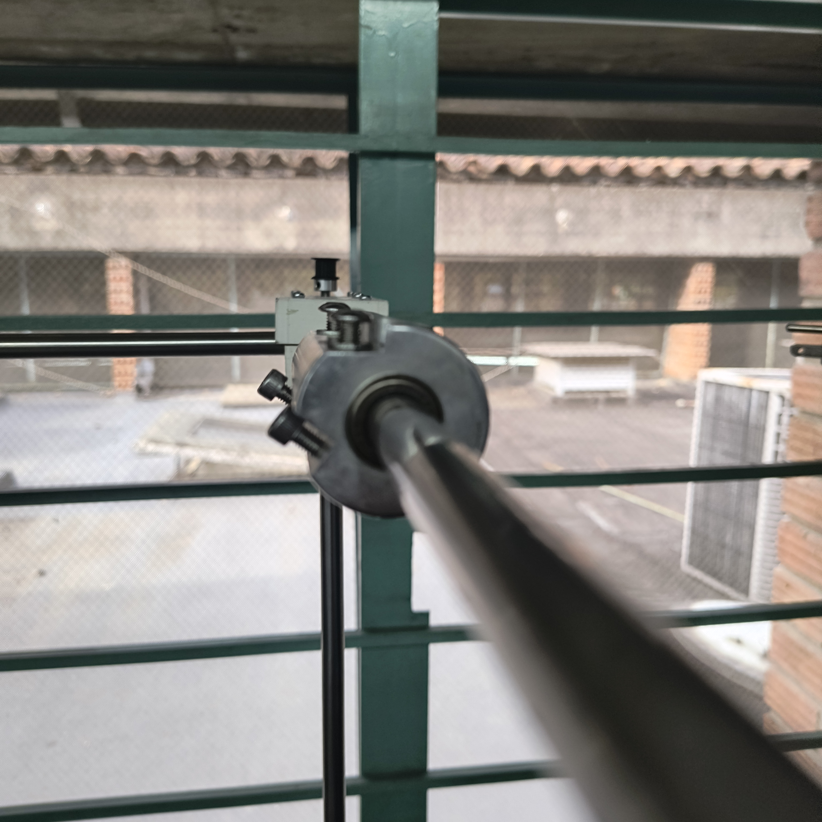
media/photos/assembly/linear_slide_bush.jpg
