JEPAltam/FFF-3DPrinter-CoreXY-Duet-LoadCell/media/photos/assembly/Machining.jpg

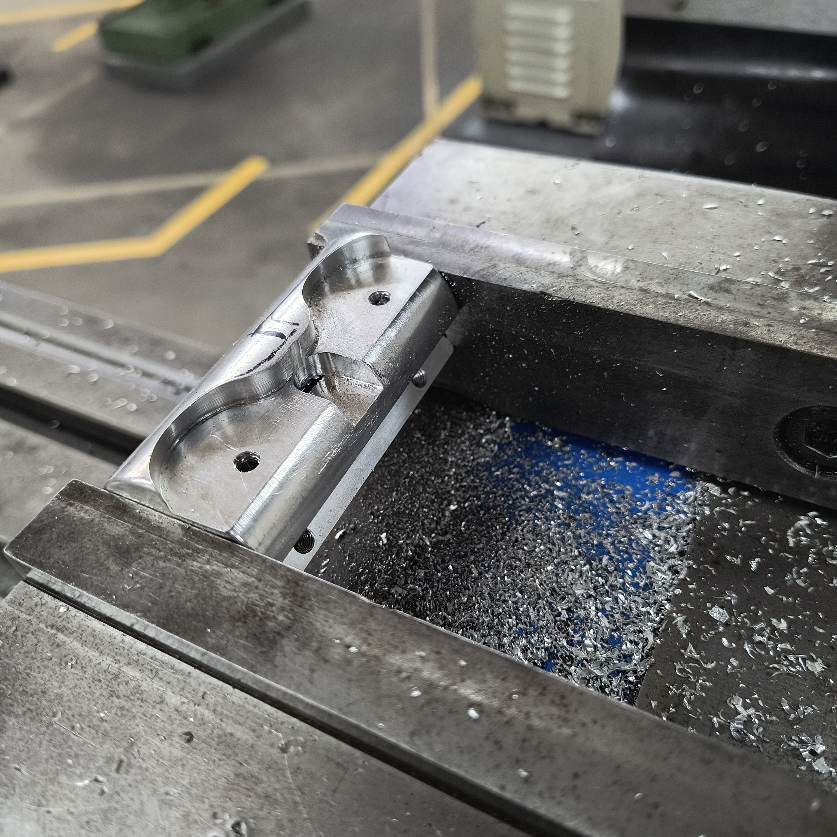
media/photos/assembly/Machining.jpg
