JEPAltam/FFF-3DPrinter-CoreXY-Duet-LoadCell/media/photos/assembly/main_frame.jpg

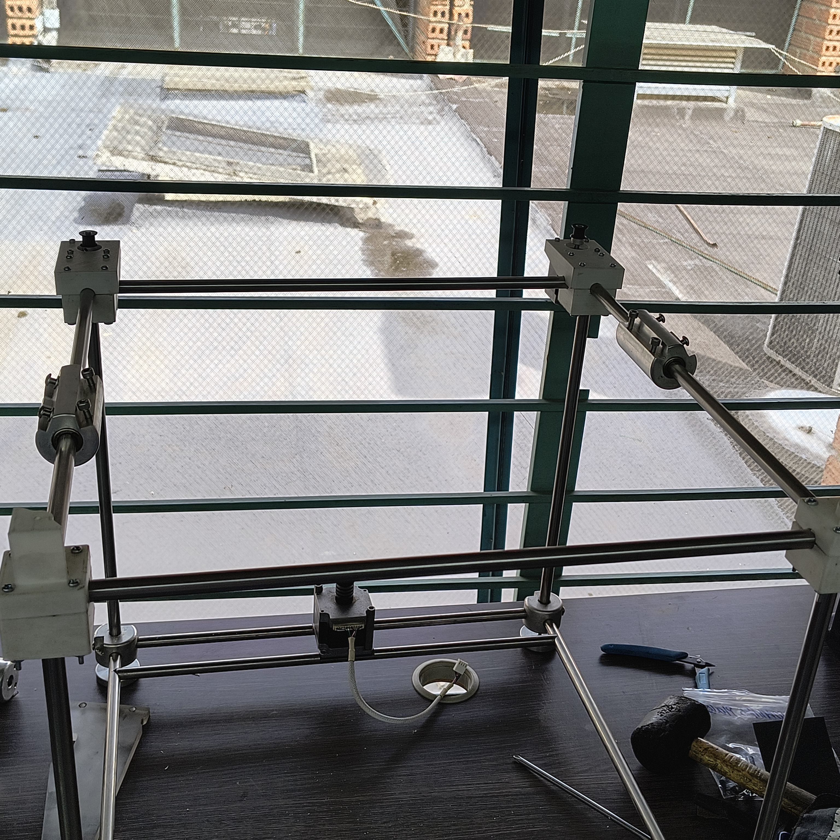
media/photos/assembly/main_frame.jpg
