JEPAltam/FFF-3DPrinter-CoreXY-Duet-LoadCell/media/photos/assembly/Slidings.jpg

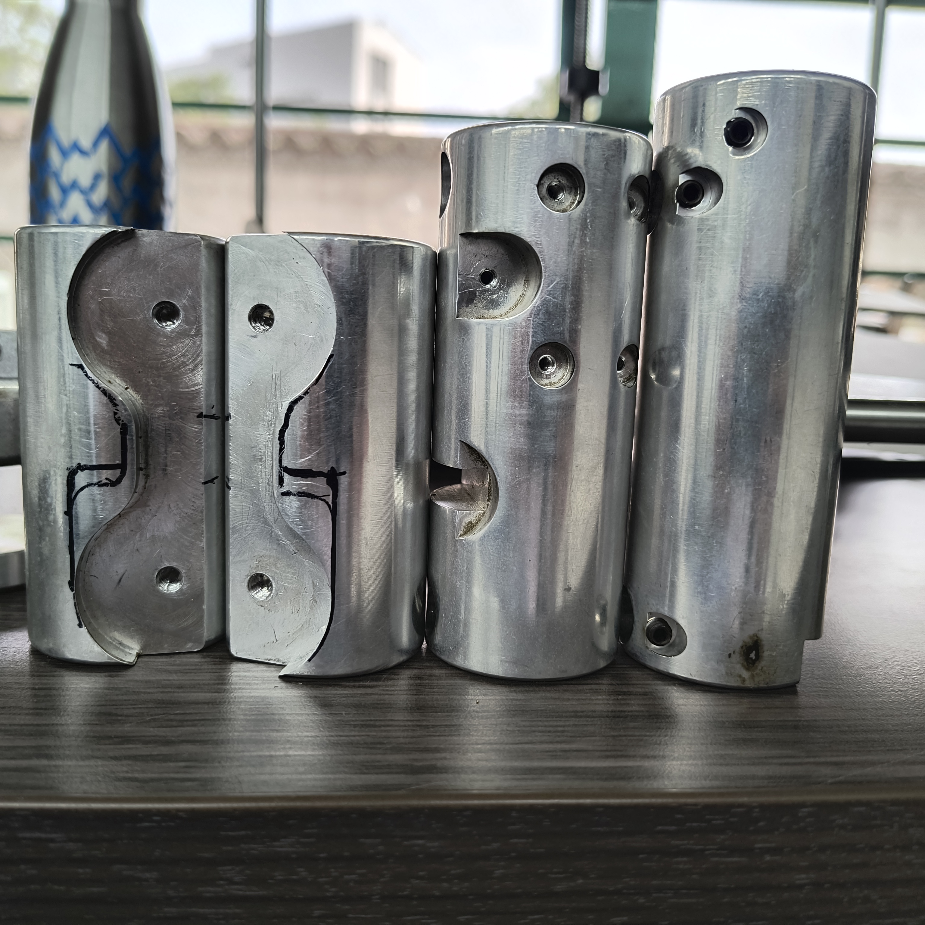
media/photos/assembly/Slidings.jpg
