JEPAltam/FFF-3DPrinter-CoreXY-Duet-LoadCell/media/photos/finished_machine/Reactivation_Upgrading_FFF_3D_Printer_CoreXY.jpg

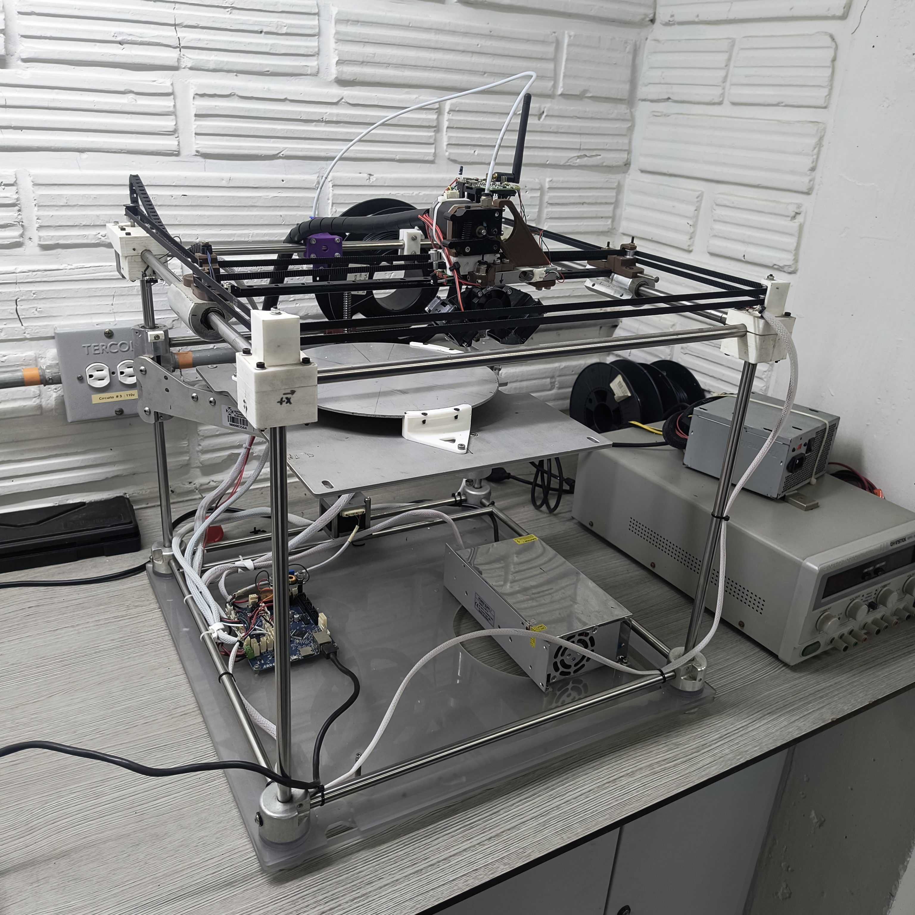
media/photos/finished_machine/Reactivation_Upgrading_FFF_3D_Printer_CoreXY.jpg
