JEPAltam/FFF-3DPrinter-CoreXY-Duet-LoadCell/media/photos/print_head/extruder.jpg

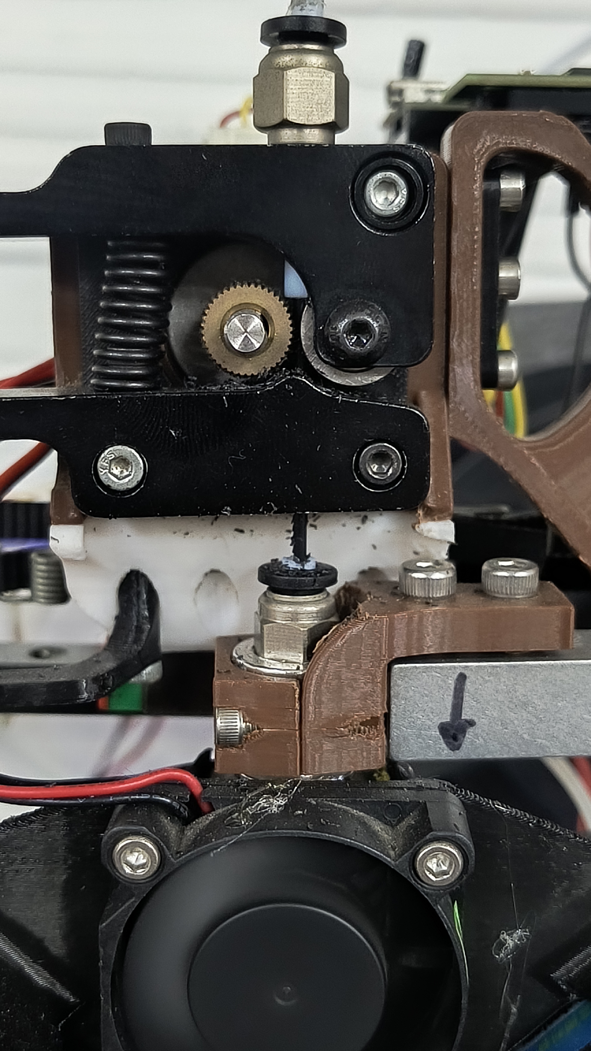
media/photos/print_head/extruder.jpg
