JEPAltam/FFF-3DPrinter-CoreXY-Duet-LoadCell/media/photos/print_head/print_head.jpg

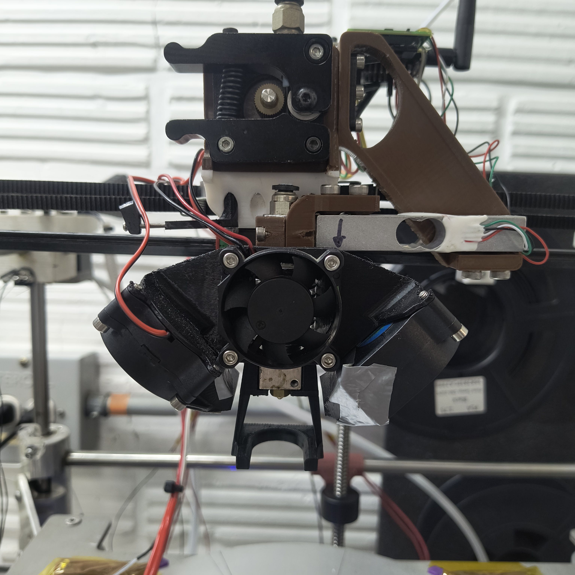
media/photos/print_head/print_head.jpg
