JEPAltam/FFF-3DPrinter-CoreXY-Duet-LoadCell/media/photos/print_head/printing.jpg

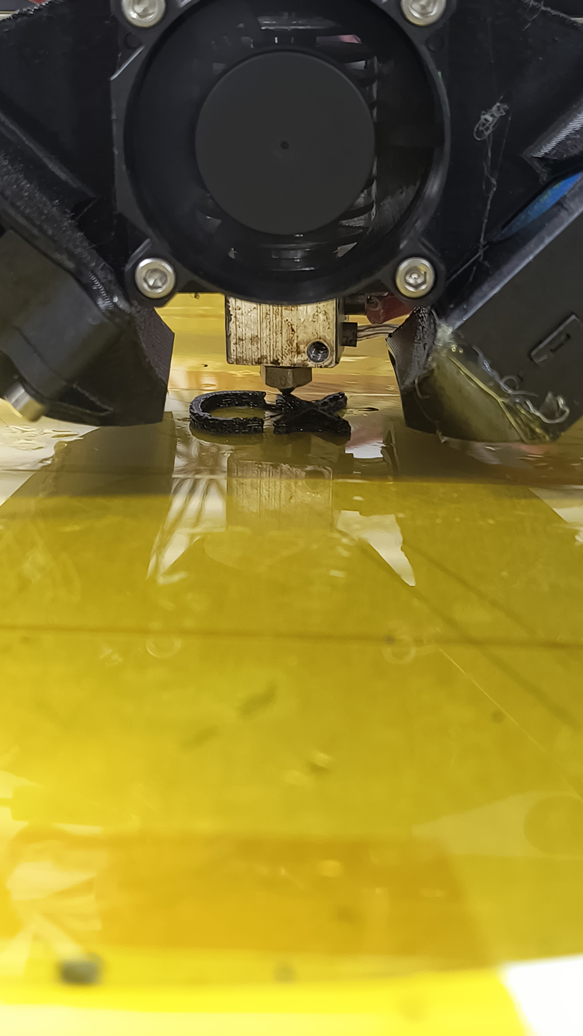
media/photos/print_head/printing.jpg
