JEPAltam/FFF-3DPrinter-CoreXY-Duet-LoadCell/media/photos/print_head/print_head_calibration.jpg

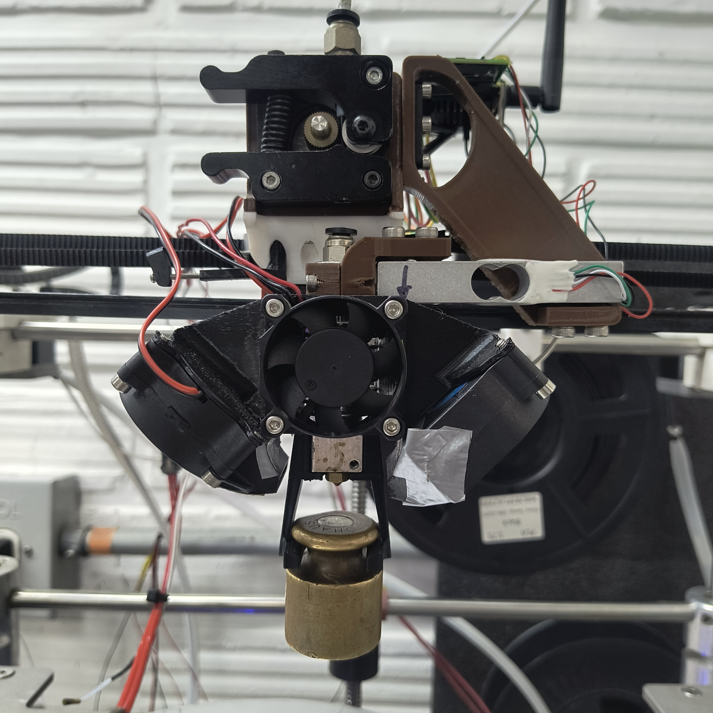
media/photos/print_head/print_head_calibration.jpg
