JEPAltam/FFF-3DPrinter-CoreXY-Duet-LoadCell/electronics/wiring_diagrams/Wiring_diagram_LoadCell_HX711.pdf

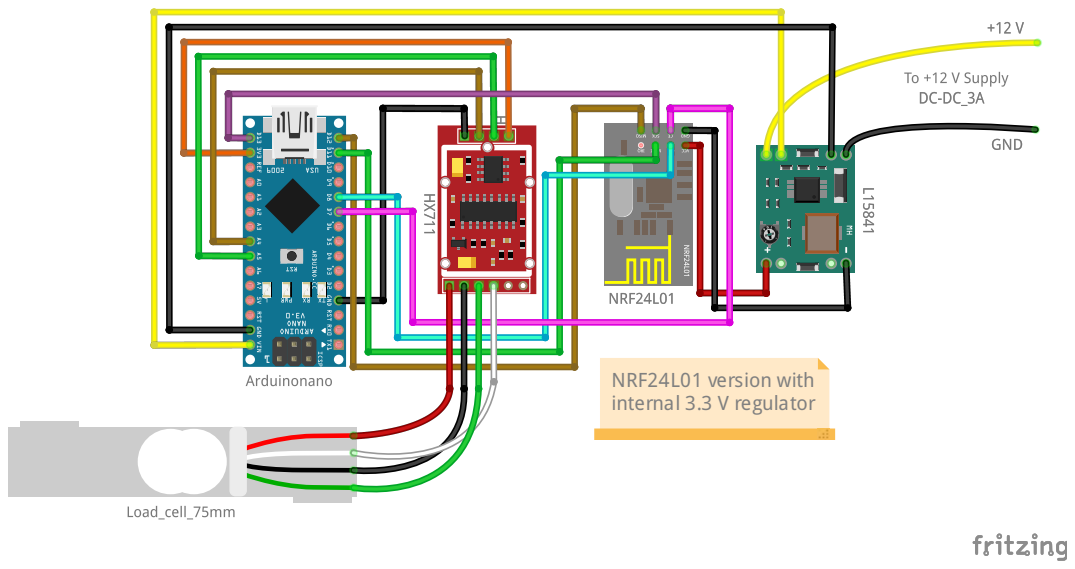
[picture p33: page 1]
NRF24L01 version with internal 3.3 V regulator
