JEPAltam/FFF-3DPrinter-CoreXY-Duet-LoadCell/electronics/schematics/schematics_Duet.pdf

# REACTIVATED CUBEX DUO 3D PRINTER WIRING DIAGRAM

## 24 V HEATER

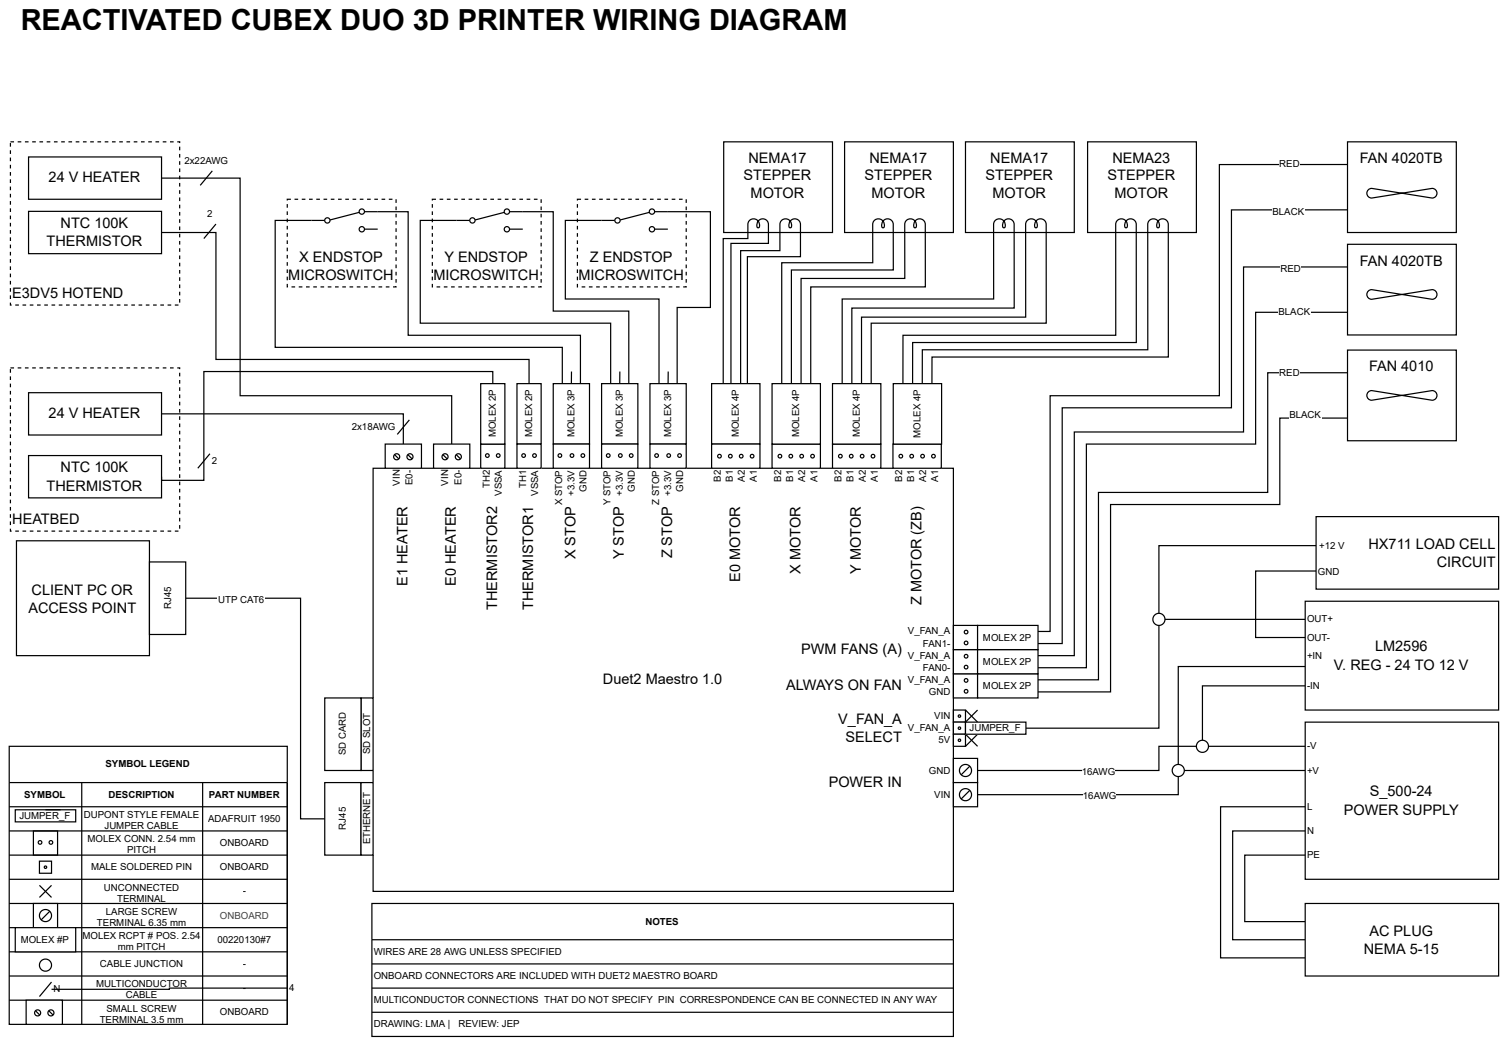
[picture p34: page 1]
HEATBED; Duet2 Maestro 1.0; POWER IN; GND; VIN; V_FAN_A SELECT; VIN V_FAN_A 5V; JUMPER_F; PWM FANS (A); V_FAN_A; FAN0-; FAN1-; VIN E0- E1 HEATER; BLACK; MOLEX 2P; RED; MOLEX 4P; Y STOP; MOLEX 3P; X STOP; GND +3.3V Z STOP; Z STOP; SYMBOL LEGEND; SYMBOL; DESCRIPTION; PART NUMBER; ADAFRUIT 1950; PITCH; ONBOARD; MALE SOLDERED PIN; mm PITCH; CABLE JUNCTION; MULTICONDUCTOR CABLE; SMALL SCREW TERMINAL 3.5 mm; VSSA; TH2 THERMISTOR2 MOLEX 2P; MOLEX 2P VSSA TH1 THERMISTOR1; E0- E0 HEATER; E0 MOTOR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

CLIENT PC OR

ALWAYS ON FAN V_FAN_A

DUPONT STYLE FEMALE
JUMPER CABLE
MOLEX CONN. 2.54 mm

UNCONNECTED
TERMINAL
LARGE SCREW
TERMINAL 6.35 mm
MOLEX RCPT # POS. 2.54

WIRES ARE 28 AWG UNLESS SPECIFIED

ONBOARD CONNECTORS ARE INCLUDED WITH DUET2 MAESTRO BOARD

MULTICONDUCTOR CONNECTIONS THAT DO NOT SPECIFY PIN CORRESPONDENCE CAN BE CONNECTED IN ANY WAY

DRAWING: LMA | REVIEW: JEP
