JEPAltam/FFF-3DPrinter-CoreXY-Duet-LoadCell/electronics/schematics/schematics_LoadCell_HX711.pdf

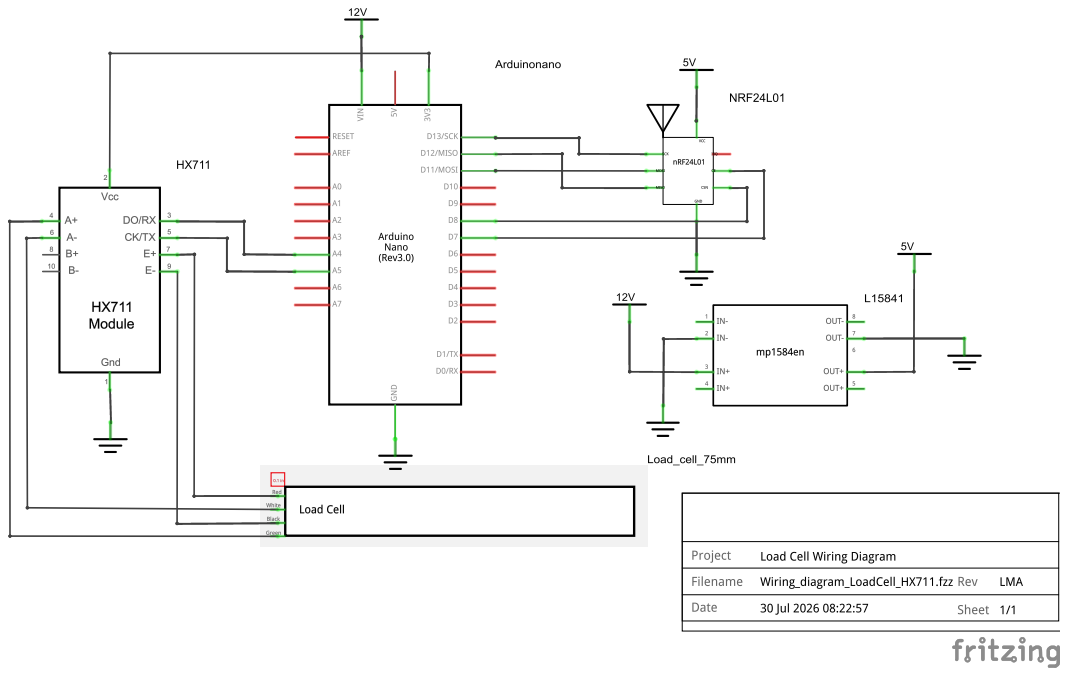
[picture p35: page 1]
