JEPAltam/FFF-3DPrinter-CoreXY-Duet-LoadCell/electronics/wiring_diagrams/DuetMaestro2_Connectors.pdf

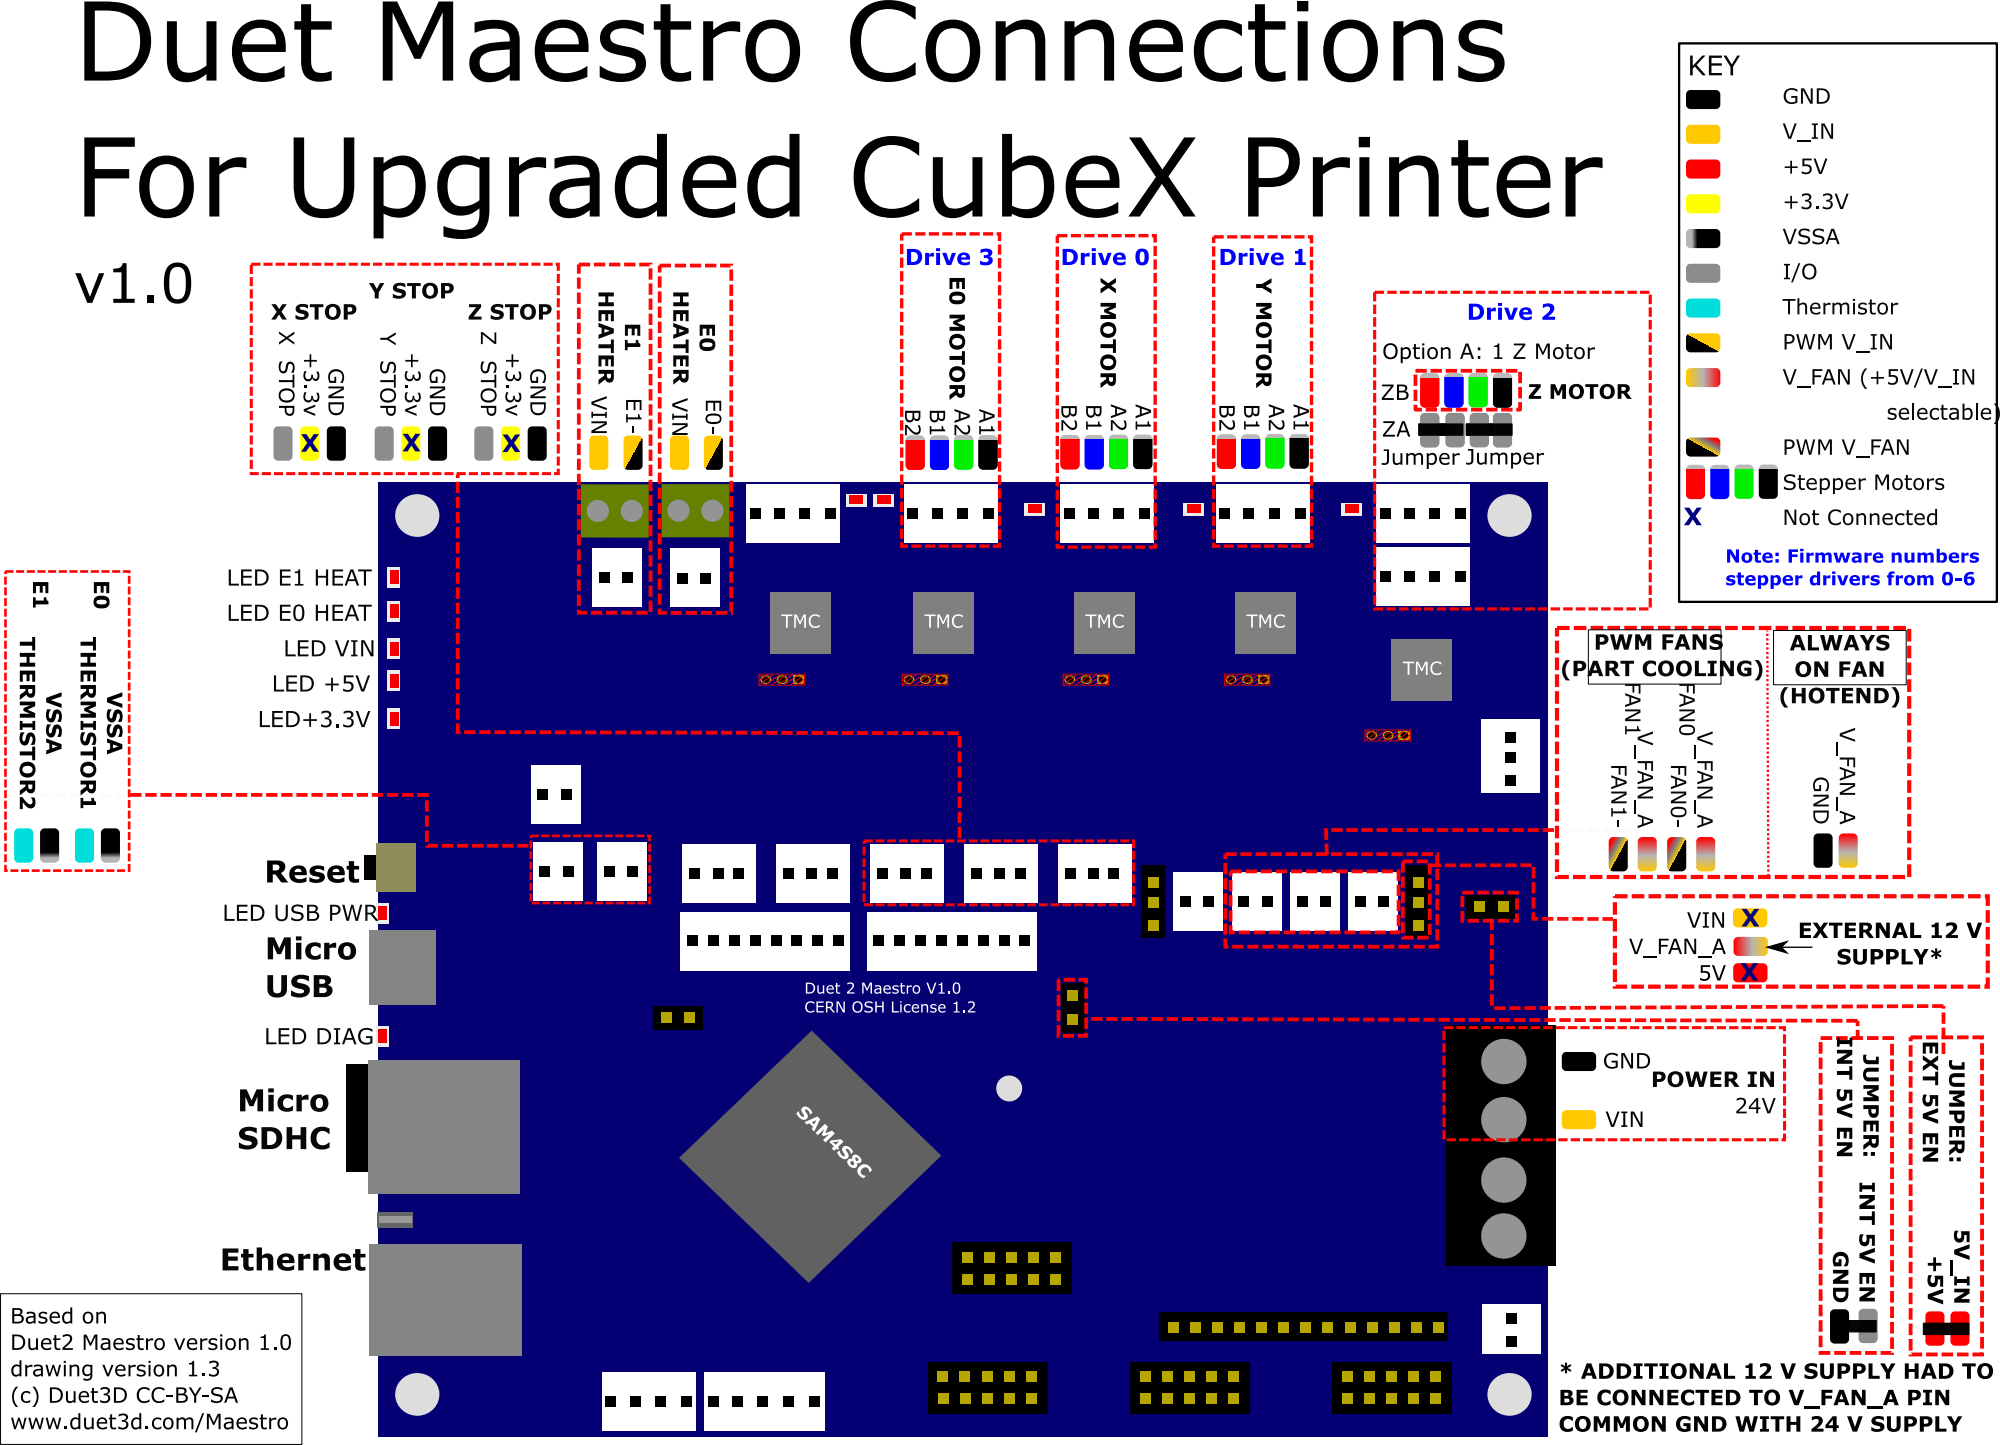
[picture p36: page 1]
