JEPAltam/FFF-3DPrinter-CoreXY-Duet-LoadCell/firmware/duet/sys/config.g

; Configuration file for RepRapFirmware on Duet 2 Maestro (discontinued)
; executed by the firmware on start-up
;
; generated by RepRapFirmware Configuration Tool v3.5.10 on Wed Mar 26 2025 13:55:02 GMT-0500 (hora estándar de Colombia)

; General
G90 ; absolute coordinates
M83 ; relative extruder moves
M550 P"Duet 3" ; set hostname

; Accessories
M575 P1 S0 B57600 ; configure PanelDue support

; Network
M552 P192.168.100.20 S1 ; configure Ethernet adapter
M553 P255.255.255.0 S1 ; configure HTTP
M554 P192.168.1.1      ; Set gateway

; Kinematics
M669 K1 ; configure CoreXY kinematics
; Kinematics is CoreXY, no segmentation, matrix:
;1.00 1.00 0
;1.00 -1.00 0
;0 0 1.00

; Smart Drivers
M569 P0 S1 D2 ; driver 0 goes forwards (X axis)
M569 P1 S1 D2 ; driver 1 goes forwards (Y axis)
M569 P2 S1 D2 ; driver 2 goes forwards (Z axis)
M569 P3 S1 D2  ; driver 3 goes forwards (E)
M584 X0 Y1 Z2 E3  ; Ejes X e Y asignados a motores A y B

;Tools
M563 P0 D0 H1 F0            ; Herramienta 0 con extrusor 0 y calentador 1 calentador cama fan0 (ventilador de capa) fan1 ventilador de disipador
G10 P0 X0 Y0 Z0         ; Offset de herramienta
G10 P0 R0 S0            ; set initial tool 0 active and standby temperatures to 0C
T0                      ; Activar herramienta al inicio

; thermistor and Heater
M308 S1 P"e0temp" Y"thermistor" T100000 B4725 C7.06e-8           ; configure sensor #0
M950 H1 C"e0heat" T1
M307 H1 R3.077 K0.478:0.000 D17.27 E1.35 S0.70 B0 V24.0          ; disable bang-bang mode for the chamber heater and set PWM limit PID active                                          ; create heater #0
;M301 H1 P1.5 I0.08 D21.1                                    ; configure model of heater #0 PID active
M143 H1 S300                                                     ; set temperature limit for heater 2 to 100C
M570 H1 P20 T30 ; Allow heater 1 to be 30°C above target for 20s before faulting

; bed Heater
M308 S0 P"e1temp" Y"thermistor" T100000 B3950                   ; configure sensor 0 as thermistor on pin bedtemp
M950 H0 C"e1heat" T0                                            ; create bed heater output on bedheat and map it to sensor 0
M307 H0 R0.974 K0.996:0.000 D10.48 E1.35 S0.5 B0               ; disable bang-bang mode for the bed heater and set PWM limit
M140 H0                                                          ; map heated bed to heater 0
M143 H0 S120                                                     ; set temperature limit for heater 0 to 120C

; 2-wire fans, normally controlled and thermostatic
M950 F0 C"fan0" Q500 ; create fan 0 on pin fan0 and set its frequency
M106 P0 S0 H-1       ; set fan 0 value. Thermostatic control is turned off
M950 F1 C"fan1" Q500 ; create fan 1 on pin fan1 and set its frequency
M106 P1 S1 H1 T45    ; set fan 1 value. Thermostatic control is turned on

; Motor Idle Current Reduction
M906 I30 ; set motor current idle factor
M84 S30 ; set motor current idle timeout

; Axes
M584 X0 Y1 Z2 E3                               ; set axis mapping
M350 X16 Y16 Z16 E16 I1                        ; configure microstepping with interpolation
M906 X800 Y800 Z1600 E800                      ; set axis driver currents
M92 X89 Y89 Z1066.7 E95.45                     ; configure steps per mm
M208 X-122 Y-122 Z0 S1                               ; set minimum 
M208 X122 Y122 Z200 S0                         ; setmaximum axis limits
M566 X800 Y800 Z12 E150                        ; set maximum instantaneous speed changes (mm/min)
M203 X9000 Y9000 Z180 E300                    ; set maximum speeds (mm/min)
M201 X400 Y400 Z20 E300                       ; set accelerations (mm/s^2)

; Endstops
M574 X1 P"xstop" S1 ; configure X axis endstop
M574 Y1 P"ystop" S1 ; configure Y axis endstop
M574 Z2 P"zstop" S1 ; configure Z axis endstop
