JEPAltam/FFF-3DPrinter-CoreXY-Duet-LoadCell/(commit log)

2026-07-10 Add project documentation, CAD files and firmware
    [AutoPID_Hotend.g, Calibrate_Extruder.g, Calibrate_X_Axis.g, Calibrate_Y_Axis.g, Calibrate_Z_Axis.g, Extruder_force_sensor.cfg, MGN12_rail.cfg, Main_frame.cfg]
2026-07-10 Add folder parts
    [Bowden_tube_Support.cfg, Bowden_tuble_guide_support.cfg, Direct_extruder.cfg, Energy_chainR.cfg, Extruder_body.cfg, Extruder_force_sensor.cfg, Fan_support.cfg, Filament_spool_holder.cfg]
2026-08-06 Restructuring of the repsoitory
    [AutoPID_Hotend.g, BOM.xlsx, Bowden_tube_Support.cfg, Bowden_tuble_guide_support.cfg, Calibrate_Extruder.g, Calibrate_X_Axis.g, Calibrate_Y_Axis.g, Calibrate_Z_Axis.g]
2026-08-06 Remove obsolete documentation and records directories
    [AutoPID_Hotend.g, Bowden_tube_Support.cfg, Bowden_tuble_guide_support.cfg, Calibrate_Extruder.g, Calibrate_X_Axis.g, Calibrate_Y_Axis.g, Calibrate_Z_Axis.g, Direct_extruder.cfg]
