JEPAltam/FFF-3DPrinter-CoreXY-Duet-LoadCell/(notices)

Notices in the files:
README.md:
License: GPL v3
